AndyEngland521/Glasses_Revision/3D Parts/Button.SLDPRT

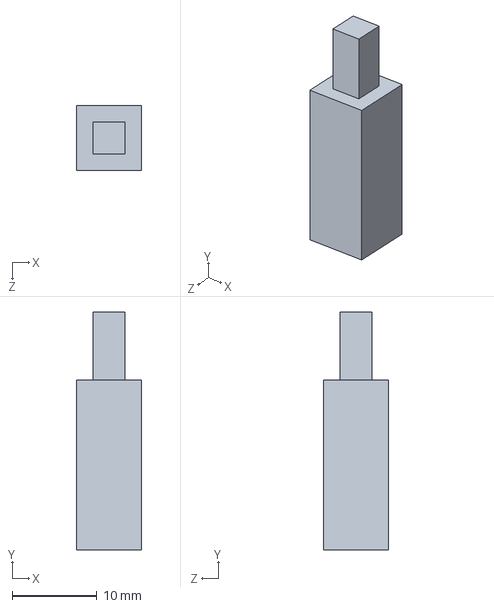
[picture p1: CAD file, 2018-12-07]
3D Parts/Button.SLDPRT
7.62 x 28.0 x 7.62 mm
