AndyEngland521/Glasses_Revision/3D Parts/Knob.SLDPRT

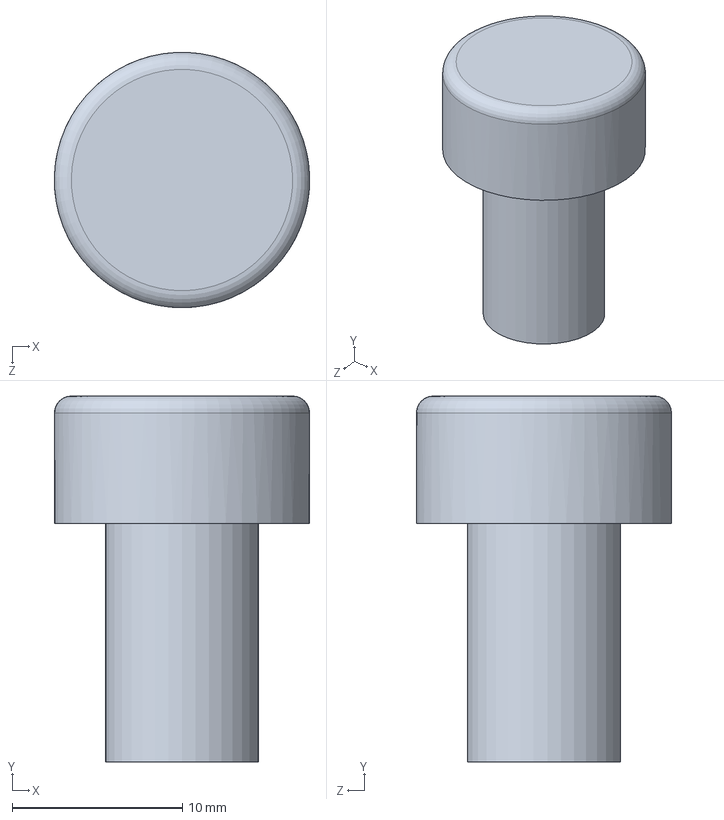
[picture p2: CAD file, 2018-12-07]
3D Parts/Knob.SLDPRT
15.0 x 21.5 x 15.0 mm
