AndyEngland521/Glasses_Revision/3D Parts/BrainBucket.SLDPRT

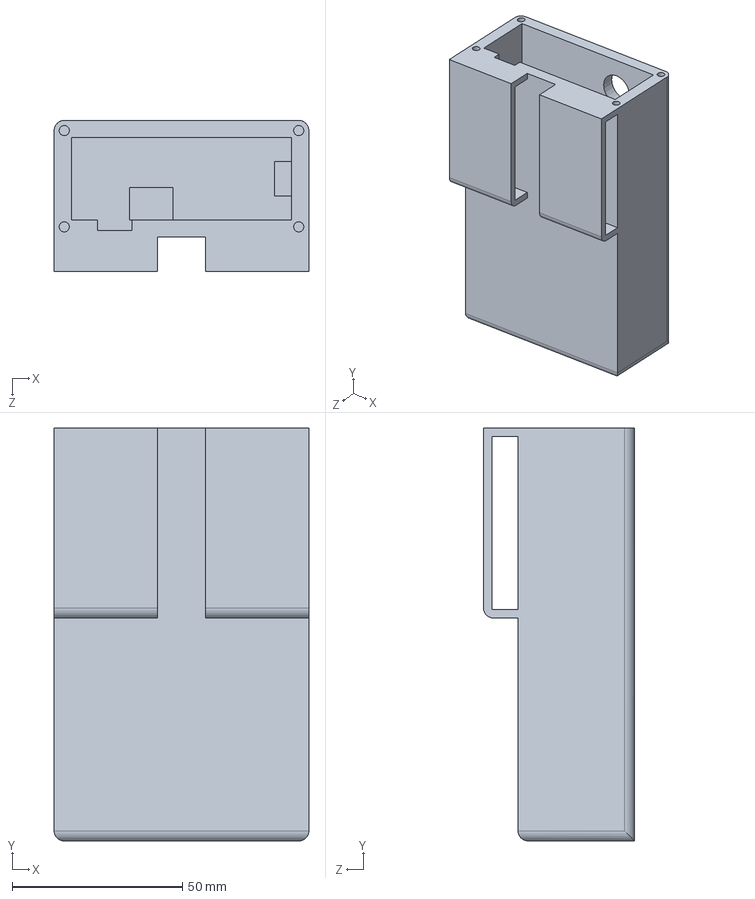
[picture p3: CAD file, 2018-12-05]
3D Parts/BrainBucket.SLDPRT
74.9 x 121.4 x 44.5 mm
