AndyEngland521/Glasses_Revision/3D Parts/BrainBucketnoLoop.SLDPRT

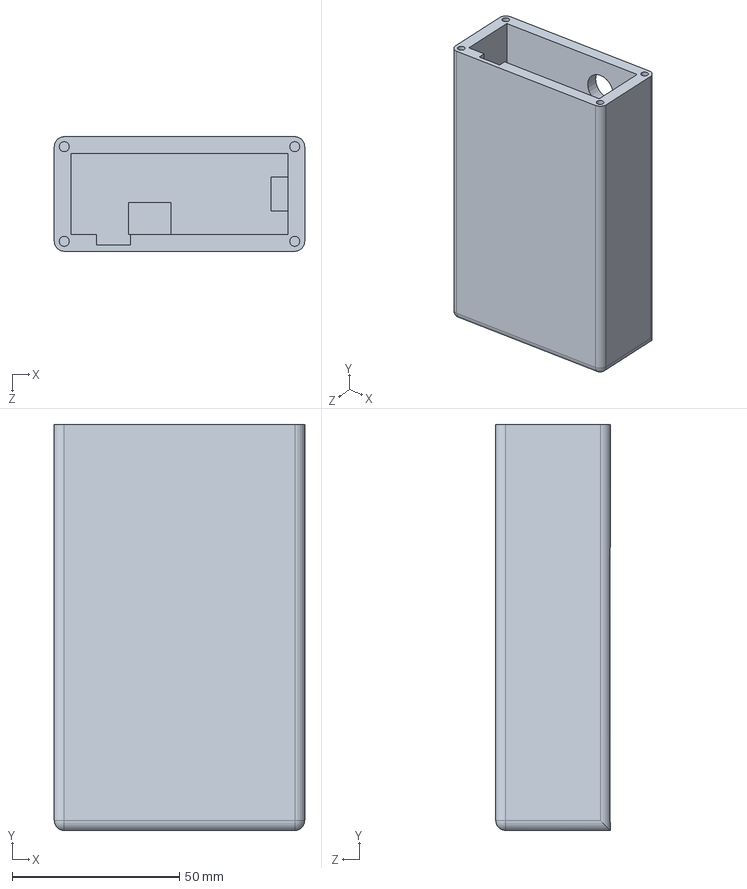
[picture p4: CAD file, 2018-12-05]
3D Parts/BrainBucketnoLoop.SLDPRT
74.9 x 121.4 x 34.3 mm
