AndyEngland521/Glasses_Revision/3D Parts/Stem.SLDPRT

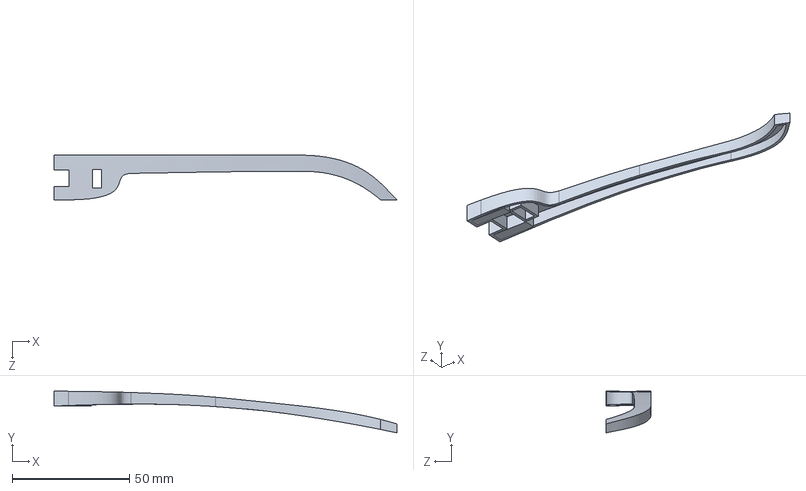
[picture p5: CAD file, 2018-12-05]
3D Parts/Stem.SLDPRT
146.1 x 17.8 x 19.1 mm
