AndyEngland521/Glasses_Revision/3D Parts/knobBottom.SLDPRT

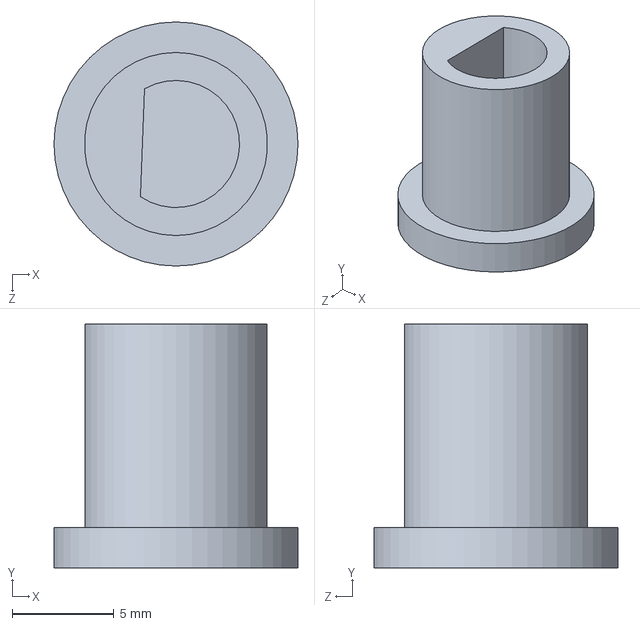
[picture p6: CAD file, 2018-06-23]
3D Parts/knobBottom.SLDPRT
12.0 x 12.0 x 12.0 mm
