AndyEngland521/Glasses_Revision/3D Parts/KnobTop.SLDPRT

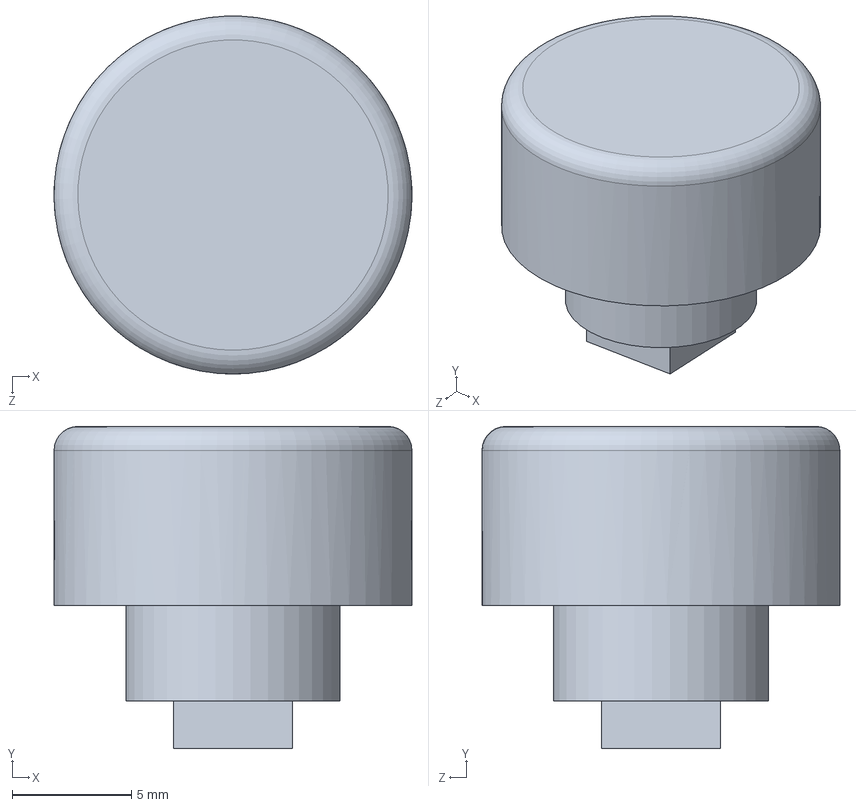
[picture p7: CAD file, 2018-06-23]
3D Parts/KnobTop.SLDPRT
15.0 x 13.5 x 15.0 mm
