AndyEngland521/Glasses_Revision/3D Parts/BrainCap.SLDPRT

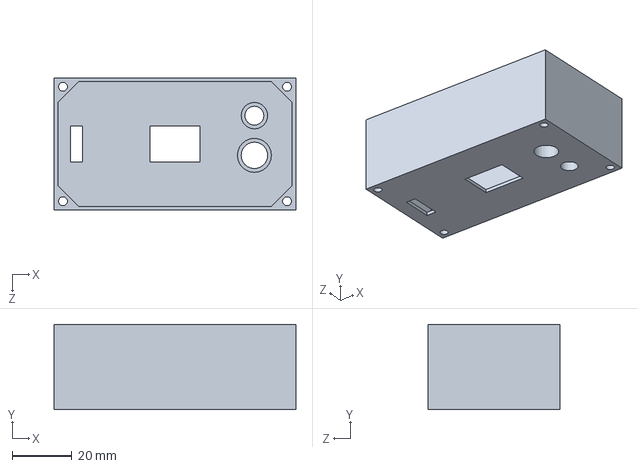
[picture p8: CAD file, 2018-05-03]
3D Parts/BrainCap.SLDPRT
81.3 x 28.6 x 44.5 mm
