AndyEngland521/Glasses_Revision/3D Parts/Stem_E.SLDPRT

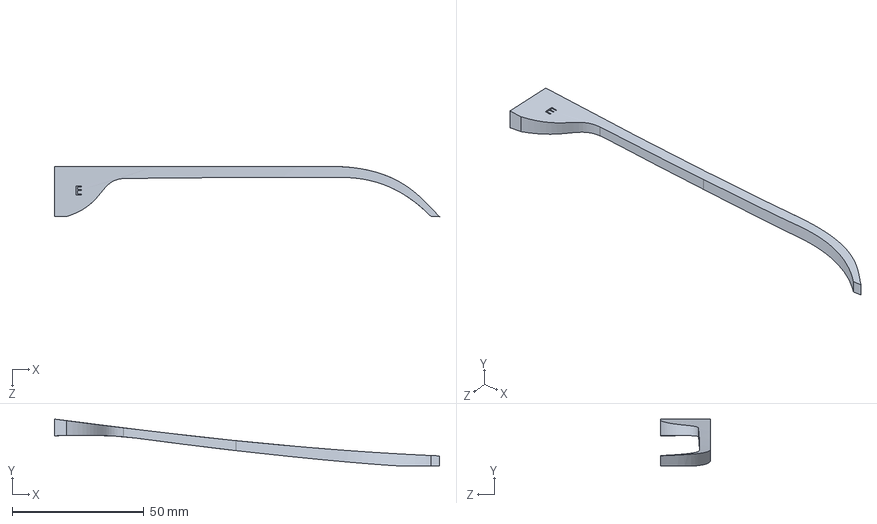
[picture p9: CAD file, 2018-03-30]
3D Parts/Stem_E.SLDPRT
146.1 x 17.8 x 19.1 mm
