AndyEngland521/Glasses_Revision/3D Parts/Stem_D.SLDPRT

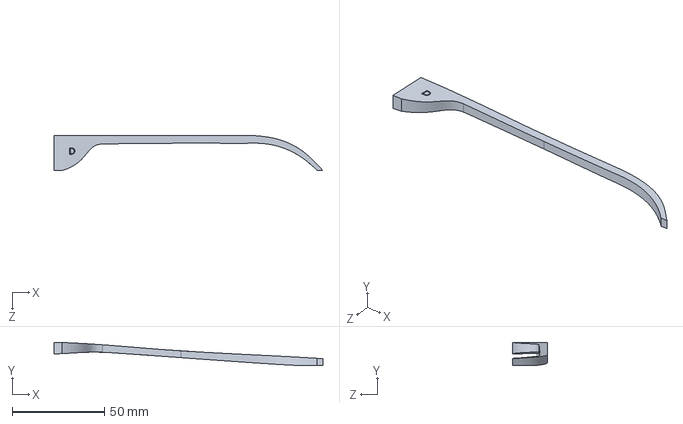
[picture p10: CAD file, 2018-03-30]
3D Parts/Stem_D.SLDPRT
146.1 x 12.7 x 19.1 mm
