AndyEngland521/Glasses_Revision/3D Parts/Stem_B.SLDPRT

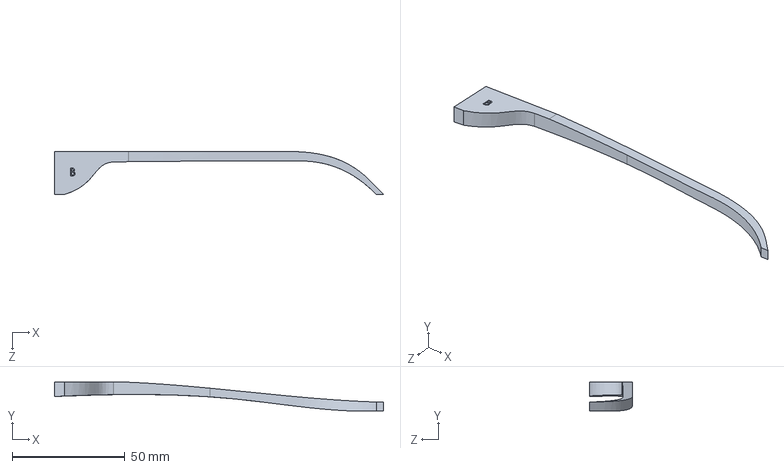
[picture p11: CAD file, 2018-03-26]
3D Parts/Stem_B.SLDPRT
146.1 x 12.7 x 19.1 mm
