AndyEngland521/Glasses_Revision/3D Parts/Stem_A.SLDPRT

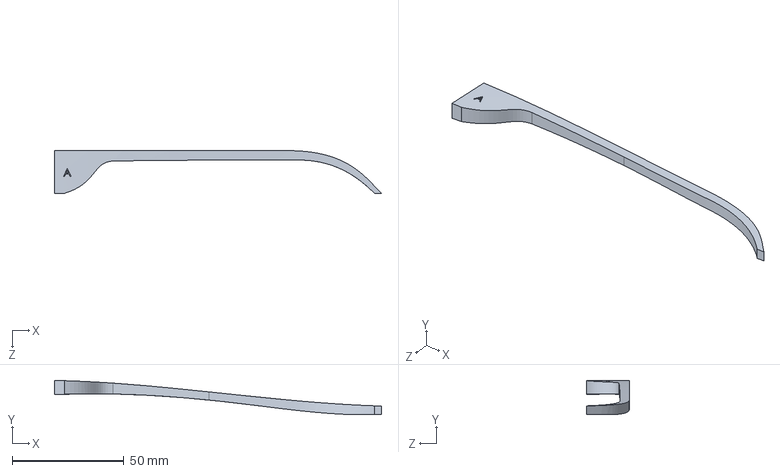
[picture p12: CAD file, 2018-03-26]
3D Parts/Stem_A.SLDPRT
146.1 x 15.2 x 19.1 mm
