AndyEngland521/Glasses_Revision/(list of files, cad)

Other CAD files:
3D Parts/Stem_C.SLDPRT
3D Parts/BrainBucket.STL
3D Parts/BrainBucketnoLoop.STL
3D Parts/BrainCap.STL
3D Parts/Button.STL
3D Parts/Knob.STL
3D Parts/KnobTop.STL
3D Parts/Stem.STL
3D Parts/Stem_A.STL
3D Parts/Stem_B.STL
3D Parts/Stem_C.STL
3D Parts/Stem_D.STL
3D Parts/Stem_E.STL
3D Parts/knobBottom.STL
