AndyEngland521/Glasses_Revision/Tutorial/AdvancedOutput.PNG

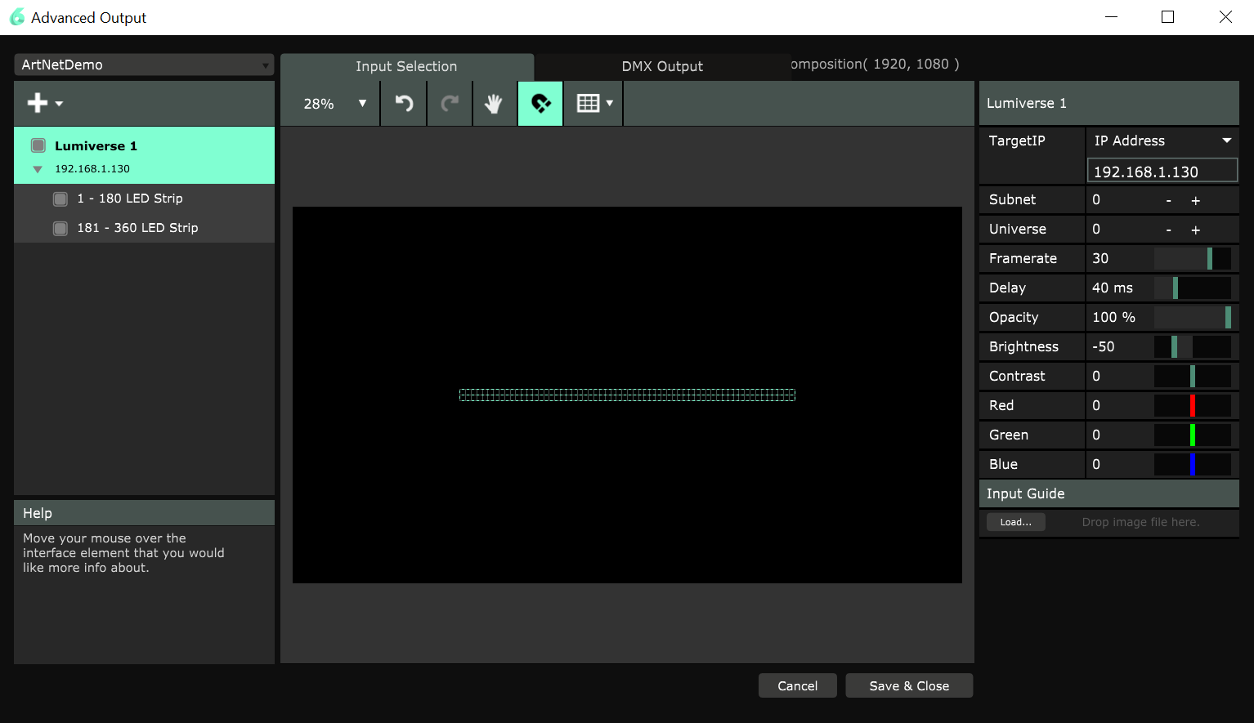
Tutorial/AdvancedOutput.PNG
