AndyEngland521/Glasses_Revision/Tutorial/CompositionSettings.PNG

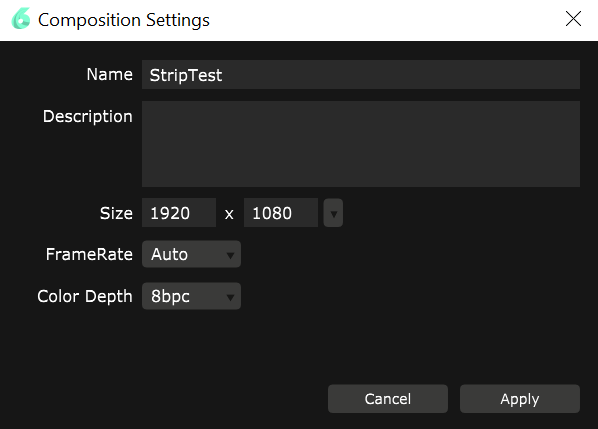
Tutorial/CompositionSettings.PNG
