AndyEngland521/Glasses_Revision/Tutorial/FixtureEditor.PNG

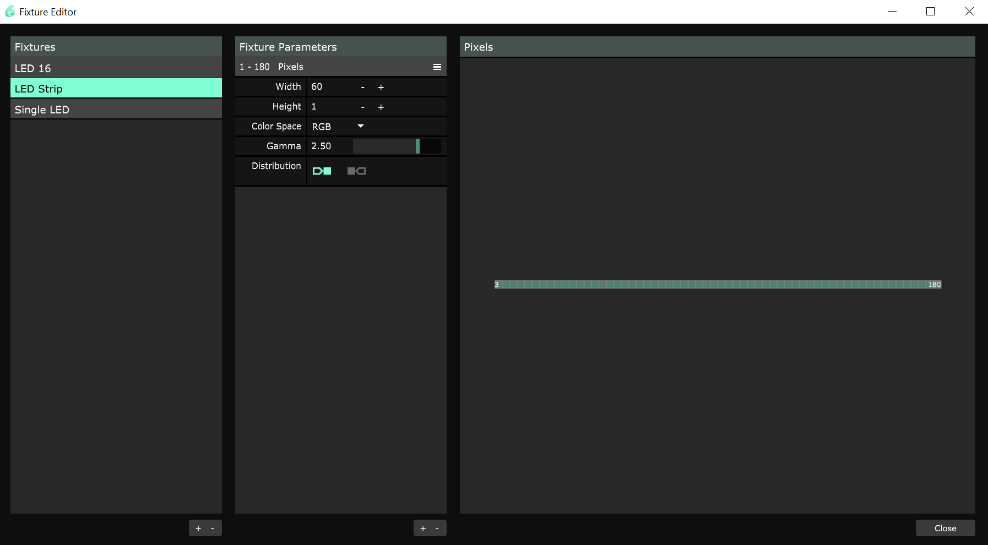
Tutorial/FixtureEditor.PNG
