AndyEngland521/Glasses_Revision/Boards/Glasses/mockup.pdf

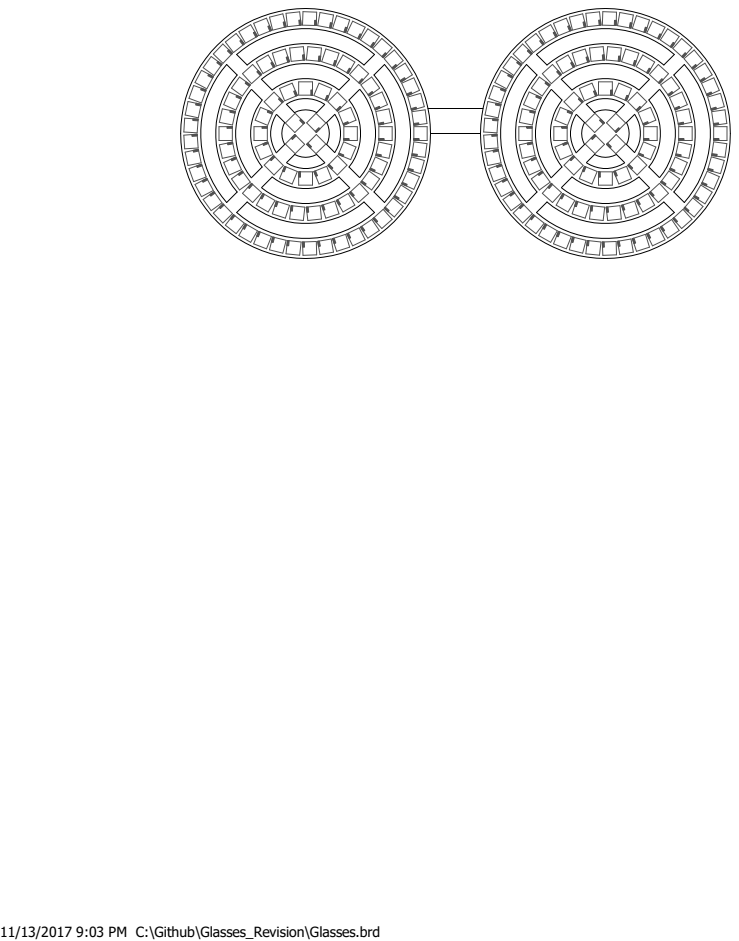
[picture p16: page 1]

11/13/2017 9:03 PM C:\Github\Glasses_Revision\Glasses.brd
