AndyEngland521/Glasses_Revision/Boards/Glasses/Glasses.brd

## EAGLE design Boards/Glasses/Glasses.brd (2018-12-06)

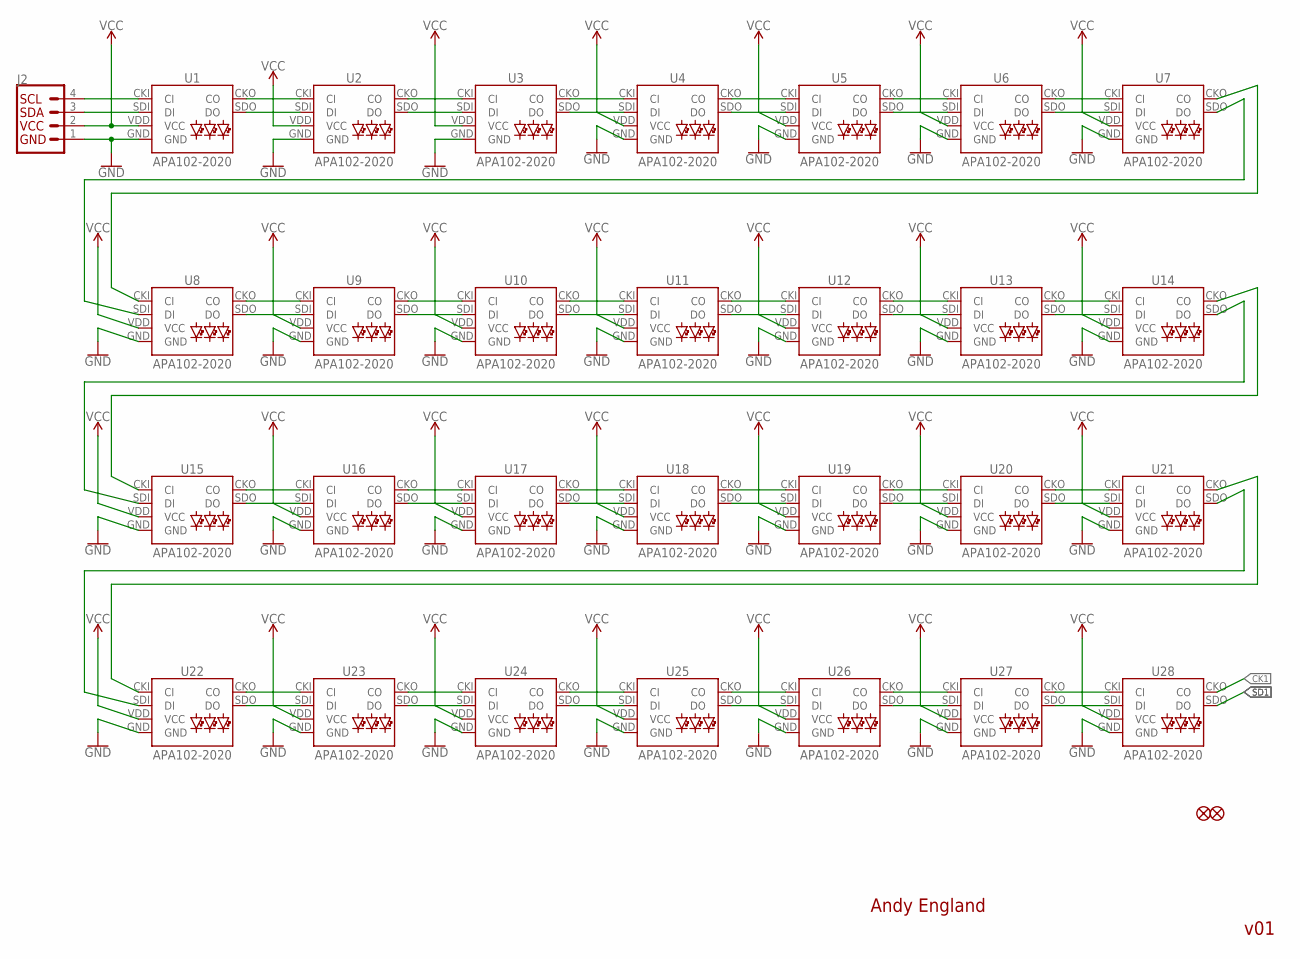
[picture p17: schematic Glasses.sch, sheet 1]

Parts:
FD1, FD2: FIDUCIALUFIDUCIAL; FIDUCIAL-MICRO
J2: QWIIC_CONNECTORJS-1MM; 1X04_1MM_RA
U1, U2, U3, U4, U5, U6, U7, U8, U9, U10, U11, U12, U13, U14, U15, U16, U17, U18, U19, U20, U21, U22, U23, U24, U25, U26, U27, U28: APA102-2020

Connections:
CK1: U28.CKO (CO); also elsewhere on the board
GND: J2.1, U1.GND, U2.GND, U3.GND, U4.GND, U5.GND, U6.GND, U7.GND, U8.GND, U9.GND, U10.GND, U11.GND, U12.GND, U13.GND, U14.GND, U15.GND, U16.GND, U17.GND, U18.GND, U19.GND, U20.GND, U21.GND, U22.GND, U23.GND, U24.GND, U25.GND, U26.GND, U27.GND, U28.GND; also elsewhere on the board
unnamed: U1.SDO (DO), U2.SDI (DI)
unnamed: U1.CKO (CO), U2.CKI (CI)
unnamed: U2.CKO (CO), U3.CKI (CI)
unnamed: U2.SDO (DO), U3.SDI (DI)
unnamed: U3.SDO (DO), U4.SDI (DI)
unnamed: U3.CKO (CO), U4.CKI (CI)
unnamed: U4.CKO (CO), U5.CKI (CI)
unnamed: U4.SDO (DO), U5.SDI (DI)
unnamed: U5.CKO (CO), U6.CKI (CI)
unnamed: U5.SDO (DO), U6.SDI (DI)
unnamed: U6.CKO (CO), U7.CKI (CI)
unnamed: U6.SDO (DO), U7.SDI (DI)
unnamed: U8.SDO (DO), U9.SDI (DI)
unnamed: U8.CKO (CO), U9.CKI (CI)
unnamed: U9.CKO (CO), U10.CKI (CI)
unnamed: U9.SDO (DO), U10.SDI (DI)
unnamed: U10.SDO (DO), U11.SDI (DI)
unnamed: U10.CKO (CO), U11.CKI (CI)
unnamed: U11.CKO (CO), U12.CKI (CI)
unnamed: U11.SDO (DO), U12.SDI (DI)
unnamed: U12.CKO (CO), U13.CKI (CI)
unnamed: U12.SDO (DO), U13.SDI (DI)
unnamed: U13.CKO (CO), U14.CKI (CI)
unnamed: U13.SDO (DO), U14.SDI (DI)
unnamed: U7.SDO (DO), U8.SDI (DI)
unnamed: U7.CKO (CO), U8.CKI (CI)
unnamed: U15.SDO (DO), U16.SDI (DI)
unnamed: U15.CKO (CO), U16.CKI (CI)
unnamed: U16.CKO (CO), U17.CKI (CI)
unnamed: U16.SDO (DO), U17.SDI (DI)
unnamed: U17.SDO (DO), U18.SDI (DI)
unnamed: U17.CKO (CO), U18.CKI (CI)
unnamed: U18.CKO (CO), U19.CKI (CI)
unnamed: U18.SDO (DO), U19.SDI (DI)
unnamed: U19.CKO (CO), U20.CKI (CI)
unnamed: U19.SDO (DO), U20.SDI (DI)
unnamed: U20.CKO (CO), U21.CKI (CI)
unnamed: U20.SDO (DO), U21.SDI (DI)
unnamed: U22.SDO (DO), U23.SDI (DI)
unnamed: U22.CKO (CO), U23.CKI (CI)
unnamed: U23.CKO (CO), U24.CKI (CI)
unnamed: U23.SDO (DO), U24.SDI (DI)
unnamed: U24.SDO (DO), U25.SDI (DI)
unnamed: U24.CKO (CO), U25.CKI (CI)
unnamed: U25.CKO (CO), U26.CKI (CI)
unnamed: U25.SDO (DO), U26.SDI (DI)
unnamed: U26.CKO (CO), U27.CKI (CI)
unnamed: U26.SDO (DO), U27.SDI (DI)
unnamed: U27.CKO (CO), U28.CKI (CI)
unnamed: U27.SDO (DO), U28.SDI (DI)
unnamed: U21.SDO (DO), U22.SDI (DI)
unnamed: U21.CKO (CO), U22.CKI (CI)
unnamed: U14.SDO (DO), U15.SDI (DI)
unnamed: U14.CKO (CO), U15.CKI (CI)
unnamed: J2.3, U1.SDI (DI)
unnamed: J2.4, U1.CKI (CI)
SD1: U28.SDO (DO); also elsewhere on the board
VCC: J2.2, U1.VDD (VCC), U2.VDD (VCC), U3.VDD (VCC), U4.VDD (VCC), U5.VDD (VCC), U6.VDD (VCC), U7.VDD (VCC), U8.VDD (VCC), U9.VDD (VCC), U10.VDD (VCC), U11.VDD (VCC), U12.VDD (VCC), U13.VDD (VCC), U14.VDD (VCC), U15.VDD (VCC), U16.VDD (VCC), U17.VDD (VCC), U18.VDD (VCC), U19.VDD (VCC), U20.VDD (VCC), U21.VDD (VCC), U22.VDD (VCC), U23.VDD (VCC), U24.VDD (VCC), U25.VDD (VCC), U26.VDD (VCC), U27.VDD (VCC), U28.VDD (VCC); also elsewhere on the board

Notes on the sheet:
Andy England
v01

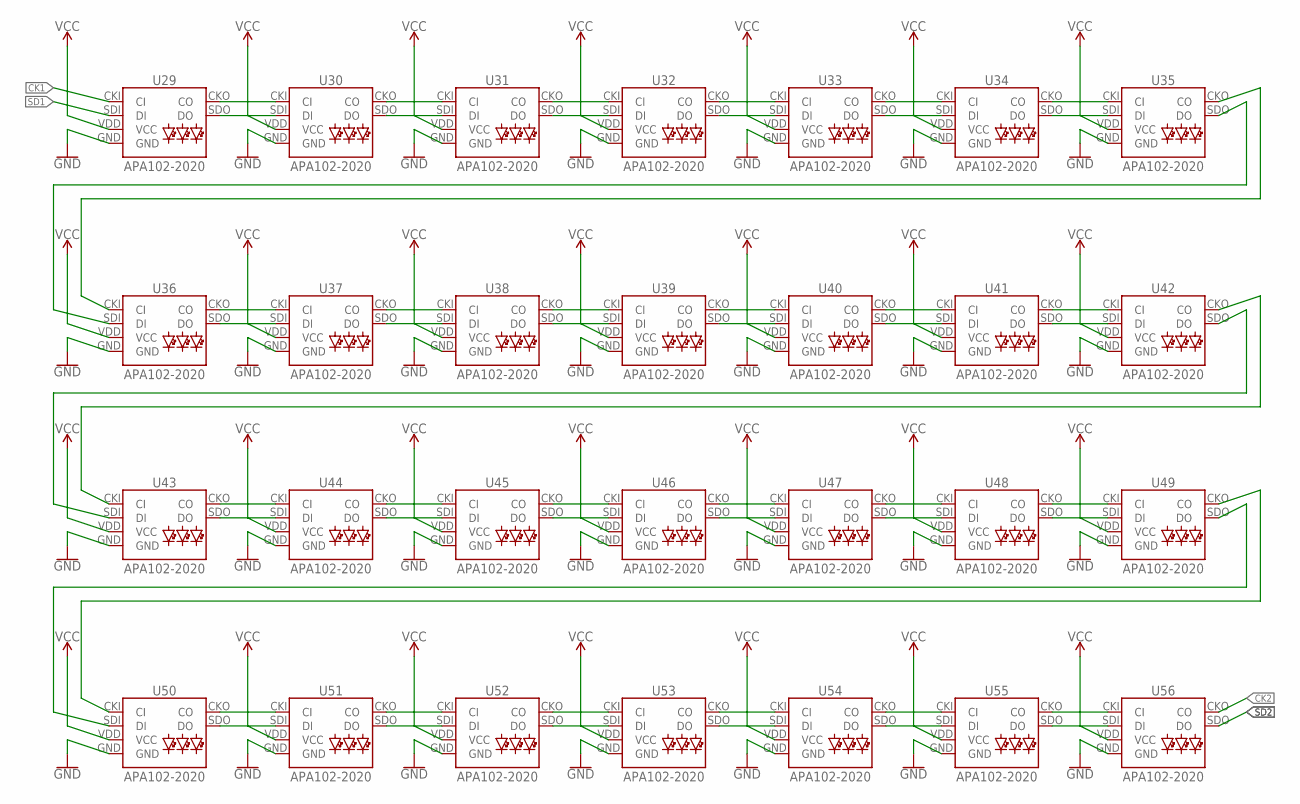
[picture p18: schematic Glasses.sch, sheet 2]

Parts:
U29, U30, U31, U32, U33, U34, U35, U36, U37, U38, U39, U40, U41, U42, U43, U44, U45, U46, U47, U48, U49, U50, U51, U52, U53, U54, U55, U56: APA102-2020

Connections:
CK1: U29.CKI (CI); also elsewhere on the board
CK2: U56.CKO (CO); also elsewhere on the board
GND: U29.GND, U30.GND, U31.GND, U32.GND, U33.GND, U34.GND, U35.GND, U36.GND, U37.GND, U38.GND, U39.GND, U40.GND, U41.GND, U42.GND, U43.GND, U44.GND, U45.GND, U46.GND, U47.GND, U48.GND, U49.GND, U50.GND, U51.GND, U52.GND, U53.GND, U54.GND, U55.GND, U56.GND; also elsewhere on the board
unnamed: U29.SDO (DO), U30.SDI (DI)
unnamed: U29.CKO (CO), U30.CKI (CI)
unnamed: U30.CKO (CO), U31.CKI (CI)
unnamed: U30.SDO (DO), U31.SDI (DI)
unnamed: U31.SDO (DO), U32.SDI (DI)
unnamed: U31.CKO (CO), U32.CKI (CI)
unnamed: U32.CKO (CO), U33.CKI (CI)
unnamed: U32.SDO (DO), U33.SDI (DI)
unnamed: U33.CKO (CO), U34.CKI (CI)
unnamed: U33.SDO (DO), U34.SDI (DI)
unnamed: U34.CKO (CO), U35.CKI (CI)
unnamed: U34.SDO (DO), U35.SDI (DI)
unnamed: U36.SDO (DO), U37.SDI (DI)
unnamed: U36.CKO (CO), U37.CKI (CI)
unnamed: U37.CKO (CO), U38.CKI (CI)
unnamed: U37.SDO (DO), U38.SDI (DI)
unnamed: U38.SDO (DO), U39.SDI (DI)
unnamed: U38.CKO (CO), U39.CKI (CI)
unnamed: U39.CKO (CO), U40.CKI (CI)
unnamed: U39.SDO (DO), U40.SDI (DI)
unnamed: U40.CKO (CO), U41.CKI (CI)
unnamed: U40.SDO (DO), U41.SDI (DI)
unnamed: U41.CKO (CO), U42.CKI (CI)
unnamed: U41.SDO (DO), U42.SDI (DI)
unnamed: U35.SDO (DO), U36.SDI (DI)
unnamed: U35.CKO (CO), U36.CKI (CI)
unnamed: U43.SDO (DO), U44.SDI (DI)
unnamed: U43.CKO (CO), U44.CKI (CI)
unnamed: U44.CKO (CO), U45.CKI (CI)
unnamed: U44.SDO (DO), U45.SDI (DI)
unnamed: U45.SDO (DO), U46.SDI (DI)
unnamed: U45.CKO (CO), U46.CKI (CI)
unnamed: U46.CKO (CO), U47.CKI (CI)
unnamed: U46.SDO (DO), U47.SDI (DI)
unnamed: U47.CKO (CO), U48.CKI (CI)
unnamed: U47.SDO (DO), U48.SDI (DI)
unnamed: U48.CKO (CO), U49.CKI (CI)
unnamed: U48.SDO (DO), U49.SDI (DI)
unnamed: U50.SDO (DO), U51.SDI (DI)
unnamed: U50.CKO (CO), U51.CKI (CI)
unnamed: U51.CKO (CO), U52.CKI (CI)
unnamed: U51.SDO (DO), U52.SDI (DI)
unnamed: U52.SDO (DO), U53.SDI (DI)
unnamed: U52.CKO (CO), U53.CKI (CI)
unnamed: U53.CKO (CO), U54.CKI (CI)
unnamed: U53.SDO (DO), U54.SDI (DI)
unnamed: U54.CKO (CO), U55.CKI (CI)
unnamed: U54.SDO (DO), U55.SDI (DI)
unnamed: U55.CKO (CO), U56.CKI (CI)
unnamed: U55.SDO (DO), U56.SDI (DI)
unnamed: U49.SDO (DO), U50.SDI (DI)
unnamed: U49.CKO (CO), U50.CKI (CI)
unnamed: U42.SDO (DO), U43.SDI (DI)
unnamed: U42.CKO (CO), U43.CKI (CI)
SD1: U29.SDI (DI); also elsewhere on the board
SD2: U56.SDO (DO); also elsewhere on the board
VCC: U29.VDD (VCC), U30.VDD (VCC), U31.VDD (VCC), U32.VDD (VCC), U33.VDD (VCC), U34.VDD (VCC), U35.VDD (VCC), U36.VDD (VCC), U37.VDD (VCC), U38.VDD (VCC), U39.VDD (VCC), U40.VDD (VCC), U41.VDD (VCC), U42.VDD (VCC), U43.VDD (VCC), U44.VDD (VCC), U45.VDD (VCC), U46.VDD (VCC), U47.VDD (VCC), U48.VDD (VCC), U49.VDD (VCC), U50.VDD (VCC), U51.VDD (VCC), U52.VDD (VCC), U53.VDD (VCC), U54.VDD (VCC), U55.VDD (VCC), U56.VDD (VCC); also elsewhere on the board

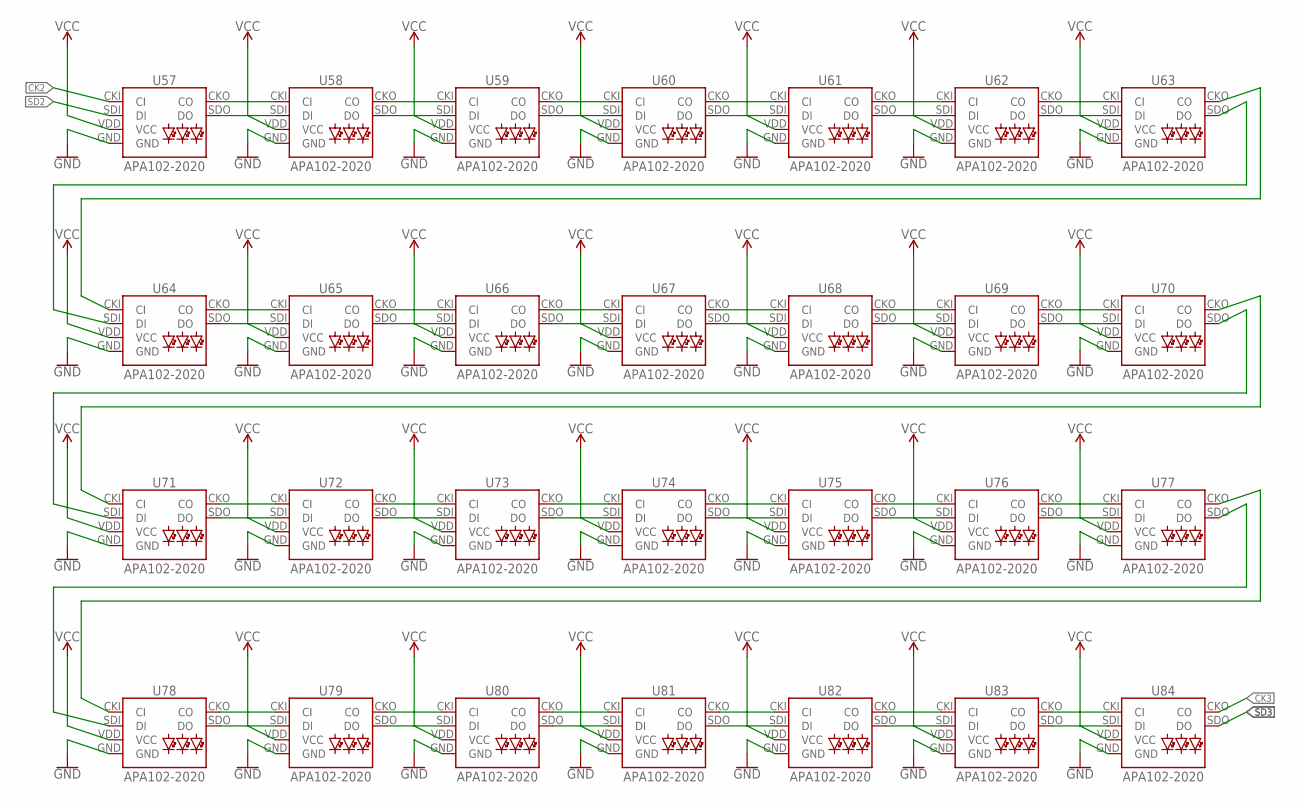
[picture p19: schematic Glasses.sch, sheet 3]

Parts:
U57, U58, U59, U60, U61, U62, U63, U64, U65, U66, U67, U68, U69, U70, U71, U72, U73, U74, U75, U76, U77, U78, U79, U80, U81, U82, U83, U84: APA102-2020

Connections:
CK2: U57.CKI (CI); also elsewhere on the board
CK3: U84.CKO (CO); also elsewhere on the board
GND: U57.GND, U58.GND, U59.GND, U60.GND, U61.GND, U62.GND, U63.GND, U64.GND, U65.GND, U66.GND, U67.GND, U68.GND, U69.GND, U70.GND, U71.GND, U72.GND, U73.GND, U74.GND, U75.GND, U76.GND, U77.GND, U78.GND, U79.GND, U80.GND, U81.GND, U82.GND, U83.GND, U84.GND; also elsewhere on the board
unnamed: U57.SDO (DO), U58.SDI (DI)
unnamed: U57.CKO (CO), U58.CKI (CI)
unnamed: U58.CKO (CO), U59.CKI (CI)
unnamed: U58.SDO (DO), U59.SDI (DI)
unnamed: U59.SDO (DO), U60.SDI (DI)
unnamed: U59.CKO (CO), U60.CKI (CI)
unnamed: U60.CKO (CO), U61.CKI (CI)
unnamed: U60.SDO (DO), U61.SDI (DI)
unnamed: U61.CKO (CO), U62.CKI (CI)
unnamed: U61.SDO (DO), U62.SDI (DI)
unnamed: U62.CKO (CO), U63.CKI (CI)
unnamed: U62.SDO (DO), U63.SDI (DI)
unnamed: U64.SDO (DO), U65.SDI (DI)
unnamed: U64.CKO (CO), U65.CKI (CI)
unnamed: U65.CKO (CO), U66.CKI (CI)
unnamed: U65.SDO (DO), U66.SDI (DI)
unnamed: U66.SDO (DO), U67.SDI (DI)
unnamed: U66.CKO (CO), U67.CKI (CI)
unnamed: U67.CKO (CO), U68.CKI (CI)
unnamed: U67.SDO (DO), U68.SDI (DI)
unnamed: U68.CKO (CO), U69.CKI (CI)
unnamed: U68.SDO (DO), U69.SDI (DI)
unnamed: U69.CKO (CO), U70.CKI (CI)
unnamed: U69.SDO (DO), U70.SDI (DI)
unnamed: U63.SDO (DO), U64.SDI (DI)
unnamed: U63.CKO (CO), U64.CKI (CI)
unnamed: U71.SDO (DO), U72.SDI (DI)
unnamed: U71.CKO (CO), U72.CKI (CI)
unnamed: U72.CKO (CO), U73.CKI (CI)
unnamed: U72.SDO (DO), U73.SDI (DI)
unnamed: U73.SDO (DO), U74.SDI (DI)
unnamed: U73.CKO (CO), U74.CKI (CI)
unnamed: U74.CKO (CO), U75.CKI (CI)
unnamed: U74.SDO (DO), U75.SDI (DI)
unnamed: U75.CKO (CO), U76.CKI (CI)
unnamed: U75.SDO (DO), U76.SDI (DI)
unnamed: U76.CKO (CO), U77.CKI (CI)
unnamed: U76.SDO (DO), U77.SDI (DI)
unnamed: U78.SDO (DO), U79.SDI (DI)
unnamed: U78.CKO (CO), U79.CKI (CI)
unnamed: U79.CKO (CO), U80.CKI (CI)
unnamed: U79.SDO (DO), U80.SDI (DI)
unnamed: U80.SDO (DO), U81.SDI (DI)
unnamed: U80.CKO (CO), U81.CKI (CI)
unnamed: U81.CKO (CO), U82.CKI (CI)
unnamed: U81.SDO (DO), U82.SDI (DI)
unnamed: U82.CKO (CO), U83.CKI (CI)
unnamed: U82.SDO (DO), U83.SDI (DI)
unnamed: U83.CKO (CO), U84.CKI (CI)
unnamed: U83.SDO (DO), U84.SDI (DI)
unnamed: U77.SDO (DO), U78.SDI (DI)
unnamed: U77.CKO (CO), U78.CKI (CI)
unnamed: U70.SDO (DO), U71.SDI (DI)
unnamed: U70.CKO (CO), U71.CKI (CI)
SD2: U57.SDI (DI); also elsewhere on the board
SD3: U84.SDO (DO); also elsewhere on the board
VCC: U57.VDD (VCC), U58.VDD (VCC), U59.VDD (VCC), U60.VDD (VCC), U61.VDD (VCC), U62.VDD (VCC), U63.VDD (VCC), U64.VDD (VCC), U65.VDD (VCC), U66.VDD (VCC), U67.VDD (VCC), U68.VDD (VCC), U69.VDD (VCC), U70.VDD (VCC), U71.VDD (VCC), U72.VDD (VCC), U73.VDD (VCC), U74.VDD (VCC), U75.VDD (VCC), U76.VDD (VCC), U77.VDD (VCC), U78.VDD (VCC), U79.VDD (VCC), U80.VDD (VCC), U81.VDD (VCC), U82.VDD (VCC), U83.VDD (VCC), U84.VDD (VCC); also elsewhere on the board

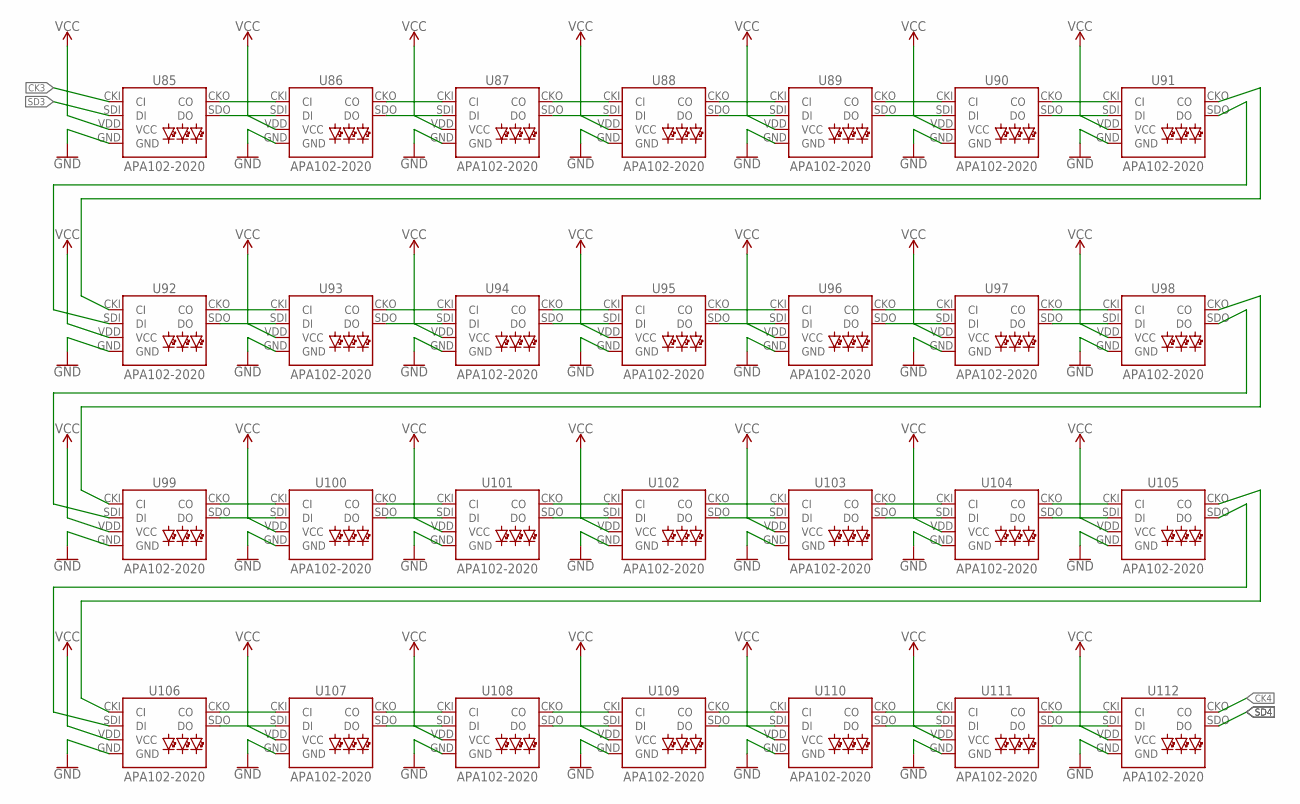
[picture p20: schematic Glasses.sch, sheet 4]

Parts:
U85, U86, U87, U88, U89, U90, U91, U92, U93, U94, U95, U96, U97, U98, U99, U100, U101, U102, U103, U104, U105, U106, U107, U108, U109, U110, U111, U112: APA102-2020

Connections:
CK3: U85.CKI (CI); also elsewhere on the board
CK4: U112.CKO (CO); also elsewhere on the board
GND: U85.GND, U86.GND, U87.GND, U88.GND, U89.GND, U90.GND, U91.GND, U92.GND, U93.GND, U94.GND, U95.GND, U96.GND, U97.GND, U98.GND, U99.GND, U100.GND, U101.GND, U102.GND, U103.GND, U104.GND, U105.GND, U106.GND, U107.GND, U108.GND, U109.GND, U110.GND, U111.GND, U112.GND; also elsewhere on the board
unnamed: U85.SDO (DO), U86.SDI (DI)
unnamed: U85.CKO (CO), U86.CKI (CI)
unnamed: U86.CKO (CO), U87.CKI (CI)
unnamed: U86.SDO (DO), U87.SDI (DI)
unnamed: U87.SDO (DO), U88.SDI (DI)
unnamed: U87.CKO (CO), U88.CKI (CI)
unnamed: U88.CKO (CO), U89.CKI (CI)
unnamed: U88.SDO (DO), U89.SDI (DI)
unnamed: U89.CKO (CO), U90.CKI (CI)
unnamed: U89.SDO (DO), U90.SDI (DI)
unnamed: U90.CKO (CO), U91.CKI (CI)
unnamed: U90.SDO (DO), U91.SDI (DI)
unnamed: U92.SDO (DO), U93.SDI (DI)
unnamed: U92.CKO (CO), U93.CKI (CI)
unnamed: U93.CKO (CO), U94.CKI (CI)
unnamed: U93.SDO (DO), U94.SDI (DI)
unnamed: U94.SDO (DO), U95.SDI (DI)
unnamed: U94.CKO (CO), U95.CKI (CI)
unnamed: U95.SDO (DO), U96.SDI (DI)
unnamed: U95.CKO (CO), U96.CKI (CI)
unnamed: U96.CKO (CO), U97.CKI (CI)
unnamed: U96.SDO (DO), U97.SDI (DI)
unnamed: U97.CKO (CO), U98.CKI (CI)
unnamed: U97.SDO (DO), U98.SDI (DI)
unnamed: U91.SDO (DO), U92.SDI (DI)
unnamed: U91.CKO (CO), U92.CKI (CI)
unnamed: U99.SDO (DO), U100.SDI (DI)
unnamed: U99.CKO (CO), U100.CKI (CI)
unnamed: U100.CKO (CO), U101.CKI (CI)
unnamed: U100.SDO (DO), U101.SDI (DI)
unnamed: U101.SDO (DO), U102.SDI (DI)
unnamed: U101.CKO (CO), U102.CKI (CI)
unnamed: U102.CKO (CO), U103.CKI (CI)
unnamed: U102.SDO (DO), U103.SDI (DI)
unnamed: U103.CKO (CO), U104.CKI (CI)
unnamed: U103.SDO (DO), U104.SDI (DI)
unnamed: U104.CKO (CO), U105.CKI (CI)
unnamed: U104.SDO (DO), U105.SDI (DI)
unnamed: U106.SDO (DO), U107.SDI (DI)
unnamed: U106.CKO (CO), U107.CKI (CI)
unnamed: U107.CKO (CO), U108.CKI (CI)
unnamed: U107.SDO (DO), U108.SDI (DI)
unnamed: U108.SDO (DO), U109.SDI (DI)
unnamed: U108.CKO (CO), U109.CKI (CI)
unnamed: U109.CKO (CO), U110.CKI (CI)
unnamed: U109.SDO (DO), U110.SDI (DI)
unnamed: U110.CKO (CO), U111.CKI (CI)
unnamed: U110.SDO (DO), U111.SDI (DI)
unnamed: U111.CKO (CO), U112.CKI (CI)
unnamed: U111.SDO (DO), U112.SDI (DI)
unnamed: U105.SDO (DO), U106.SDI (DI)
unnamed: U105.CKO (CO), U106.CKI (CI)
unnamed: U98.SDO (DO), U99.SDI (DI)
unnamed: U98.CKO (CO), U99.CKI (CI)
SD3: U85.SDI (DI); also elsewhere on the board
SD4: U112.SDO (DO); also elsewhere on the board
VCC: U85.VDD (VCC), U86.VDD (VCC), U87.VDD (VCC), U88.VDD (VCC), U89.VDD (VCC), U90.VDD (VCC), U91.VDD (VCC), U92.VDD (VCC), U93.VDD (VCC), U94.VDD (VCC), U95.VDD (VCC), U96.VDD (VCC), U97.VDD (VCC), U98.VDD (VCC), U99.VDD (VCC), U100.VDD (VCC), U101.VDD (VCC), U102.VDD (VCC), U103.VDD (VCC), U104.VDD (VCC), U105.VDD (VCC), U106.VDD (VCC), U107.VDD (VCC), U108.VDD (VCC), U109.VDD (VCC), U110.VDD (VCC), U111.VDD (VCC), U112.VDD (VCC); also elsewhere on the board

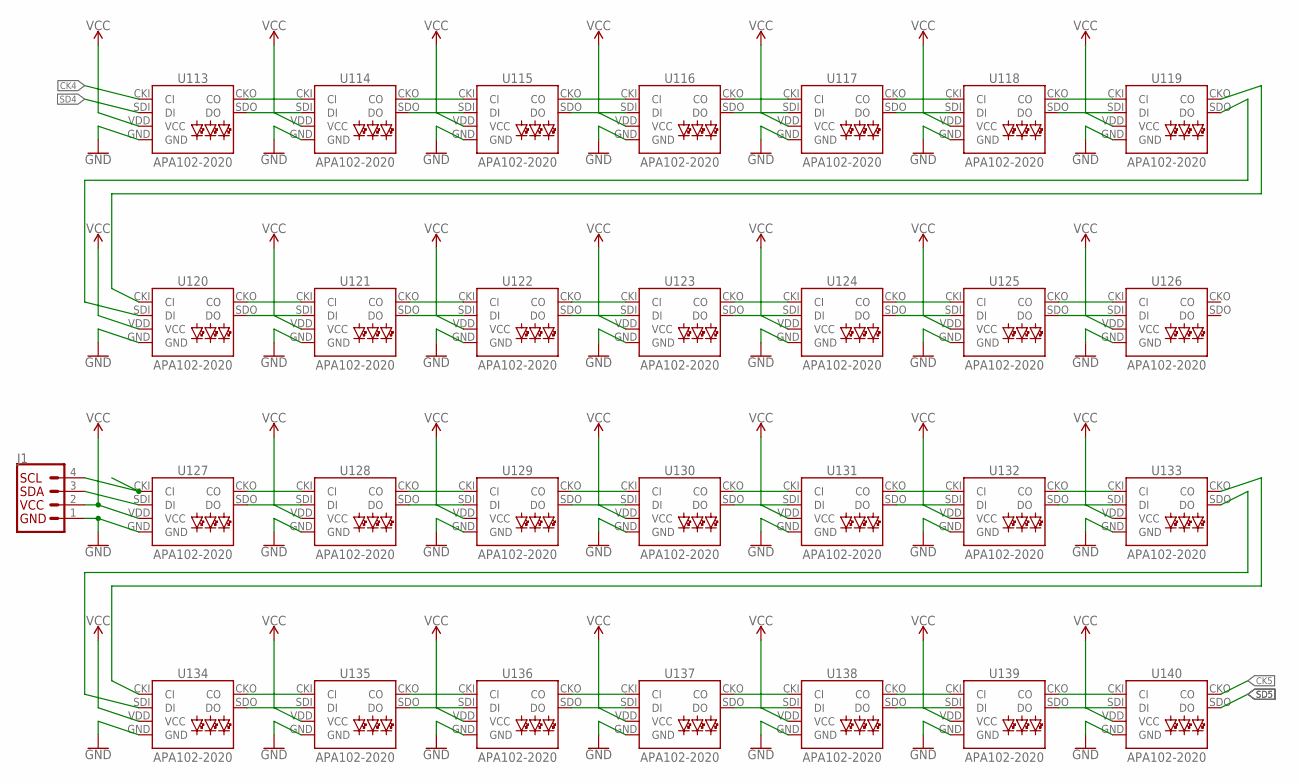
[picture p21: schematic Glasses.sch, sheet 5]

Parts:
J1: QWIIC_CONNECTORJS-1MM; 1X04_1MM_RA
U113, U114, U115, U116, U117, U118, U119, U120, U121, U122, U123, U124, U125, U126, U127, U128, U129, U130, U131, U132, U133, U134, U135, U136, U137, U138, U139, U140: APA102-2020

Connections:
CK4: U113.CKI (CI); also elsewhere on the board
CK5: U140.CKO (CO); also elsewhere on the board
GND: J1.1, U113.GND, U114.GND, U115.GND, U116.GND, U117.GND, U118.GND, U119.GND, U120.GND, U121.GND, U122.GND, U123.GND, U124.GND, U125.GND, U126.GND, U127.GND, U128.GND, U129.GND, U130.GND, U131.GND, U132.GND, U133.GND, U134.GND, U135.GND, U136.GND, U137.GND, U138.GND, U139.GND, U140.GND; also elsewhere on the board
unnamed: U113.SDO (DO), U114.SDI (DI)
unnamed: U113.CKO (CO), U114.CKI (CI)
unnamed: U114.CKO (CO), U115.CKI (CI)
unnamed: U114.SDO (DO), U115.SDI (DI)
unnamed: U115.SDO (DO), U116.SDI (DI)
unnamed: U115.CKO (CO), U116.CKI (CI)
unnamed: U116.CKO (CO), U117.CKI (CI)
unnamed: U116.SDO (DO), U117.SDI (DI)
unnamed: U117.CKO (CO), U118.CKI (CI)
unnamed: U117.SDO (DO), U118.SDI (DI)
unnamed: U118.CKO (CO), U119.CKI (CI)
unnamed: U118.SDO (DO), U119.SDI (DI)
unnamed: U120.SDO (DO), U121.SDI (DI)
unnamed: U120.CKO (CO), U121.CKI (CI)
unnamed: U121.CKO (CO), U122.CKI (CI)
unnamed: U121.SDO (DO), U122.SDI (DI)
unnamed: U122.SDO (DO), U123.SDI (DI)
unnamed: U122.CKO (CO), U123.CKI (CI)
unnamed: U123.CKO (CO), U124.CKI (CI)
unnamed: U123.SDO (DO), U124.SDI (DI)
unnamed: U124.CKO (CO), U125.CKI (CI)
unnamed: U124.SDO (DO), U125.SDI (DI)
unnamed: U125.CKO (CO), U126.CKI (CI)
unnamed: U125.SDO (DO), U126.SDI (DI)
unnamed: U119.SDO (DO), U120.SDI (DI)
unnamed: U119.CKO (CO), U120.CKI (CI)
unnamed: U127.SDO (DO), U128.SDI (DI)
unnamed: U127.CKO (CO), U128.CKI (CI)
unnamed: U128.CKO (CO), U129.CKI (CI)
unnamed: U128.SDO (DO), U129.SDI (DI)
unnamed: U129.SDO (DO), U130.SDI (DI)
unnamed: U129.CKO (CO), U130.CKI (CI)
unnamed: U130.CKO (CO), U131.CKI (CI)
unnamed: U130.SDO (DO), U131.SDI (DI)
unnamed: U131.CKO (CO), U132.CKI (CI)
unnamed: U131.SDO (DO), U132.SDI (DI)
unnamed: U132.CKO (CO), U133.CKI (CI)
unnamed: U132.SDO (DO), U133.SDI (DI)
unnamed: U134.SDO (DO), U135.SDI (DI)
unnamed: U134.CKO (CO), U135.CKI (CI)
unnamed: U135.CKO (CO), U136.CKI (CI)
unnamed: U135.SDO (DO), U136.SDI (DI)
unnamed: U136.SDO (DO), U137.SDI (DI)
unnamed: U136.CKO (CO), U137.CKI (CI)
unnamed: U137.CKO (CO), U138.CKI (CI)
unnamed: U137.SDO (DO), U138.SDI (DI)
unnamed: U138.CKO (CO), U139.CKI (CI)
unnamed: U138.SDO (DO), U139.SDI (DI)
unnamed: U139.CKO (CO), U140.CKI (CI)
unnamed: U139.SDO (DO), U140.SDI (DI)
unnamed: U133.SDO (DO), U134.SDI (DI)
unnamed: U133.CKO (CO), U134.CKI (CI)
unnamed: J1.3, U127.SDI (DI)
unnamed: J1.4, U127.CKI (CI)
SD4: U113.SDI (DI); also elsewhere on the board
SD5: U140.SDO (DO); also elsewhere on the board
VCC: J1.2, U113.VDD (VCC), U114.VDD (VCC), U115.VDD (VCC), U116.VDD (VCC), U117.VDD (VCC), U118.VDD (VCC), U119.VDD (VCC), U120.VDD (VCC), U121.VDD (VCC), U122.VDD (VCC), U123.VDD (VCC), U124.VDD (VCC), U125.VDD (VCC), U126.VDD (VCC), U127.VDD (VCC), U128.VDD (VCC), U129.VDD (VCC), U130.VDD (VCC), U131.VDD (VCC), U132.VDD (VCC), U133.VDD (VCC), U134.VDD (VCC), U135.VDD (VCC), U136.VDD (VCC), U137.VDD (VCC), U138.VDD (VCC), U139.VDD (VCC), U140.VDD (VCC); also elsewhere on the board

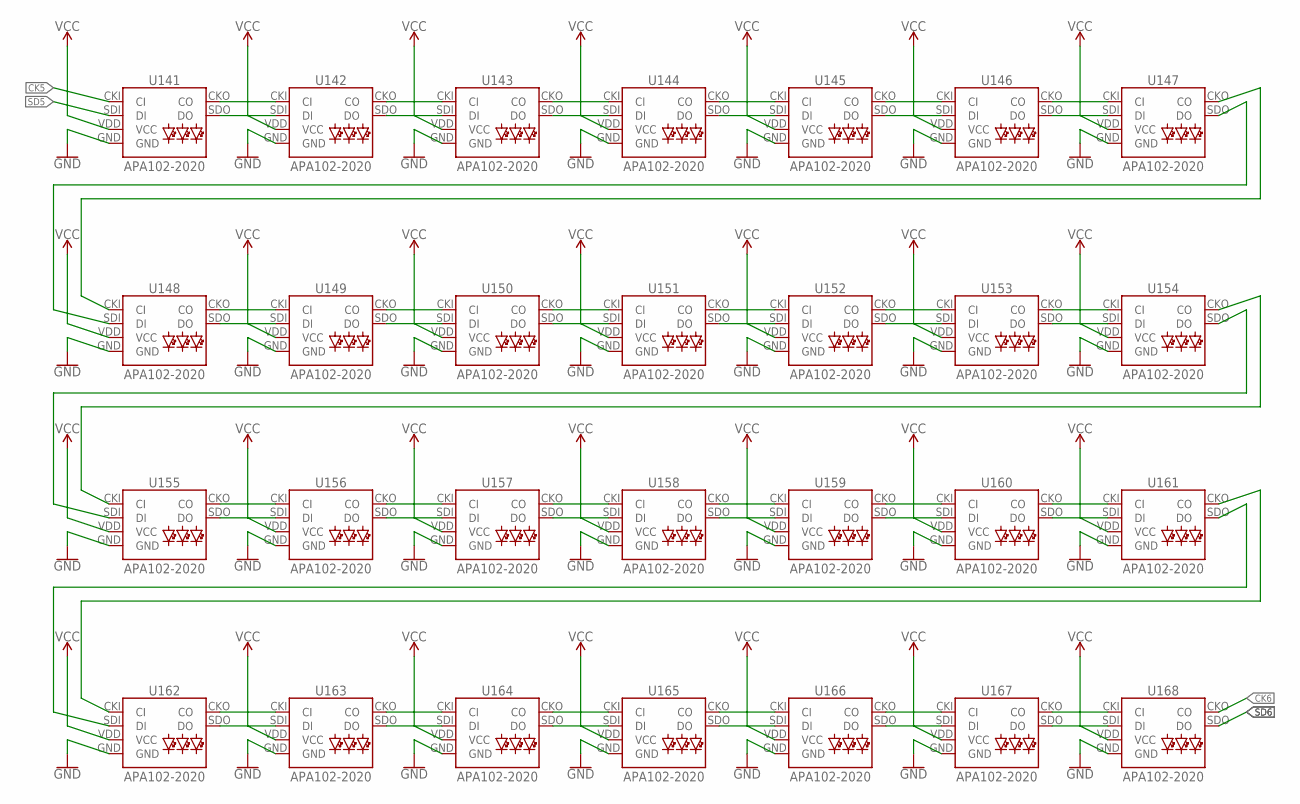
[picture p22: schematic Glasses.sch, sheet 6]

Parts:
U141, U142, U143, U144, U145, U146, U147, U148, U149, U150, U151, U152, U153, U154, U155, U156, U157, U158, U159, U160, U161, U162, U163, U164, U165, U166, U167, U168: APA102-2020

Connections:
CK5: U141.CKI (CI); also elsewhere on the board
CK6: U168.CKO (CO); also elsewhere on the board
GND: U141.GND, U142.GND, U143.GND, U144.GND, U145.GND, U146.GND, U147.GND, U148.GND, U149.GND, U150.GND, U151.GND, U152.GND, U153.GND, U154.GND, U155.GND, U156.GND, U157.GND, U158.GND, U159.GND, U160.GND, U161.GND, U162.GND, U163.GND, U164.GND, U165.GND, U166.GND, U167.GND, U168.GND; also elsewhere on the board
unnamed: U141.SDO (DO), U142.SDI (DI)
unnamed: U141.CKO (CO), U142.CKI (CI)
unnamed: U142.CKO (CO), U143.CKI (CI)
unnamed: U142.SDO (DO), U143.SDI (DI)
unnamed: U143.SDO (DO), U144.SDI (DI)
unnamed: U143.CKO (CO), U144.CKI (CI)
unnamed: U144.CKO (CO), U145.CKI (CI)
unnamed: U144.SDO (DO), U145.SDI (DI)
unnamed: U145.CKO (CO), U146.CKI (CI)
unnamed: U145.SDO (DO), U146.SDI (DI)
unnamed: U146.CKO (CO), U147.CKI (CI)
unnamed: U146.SDO (DO), U147.SDI (DI)
unnamed: U148.SDO (DO), U149.SDI (DI)
unnamed: U148.CKO (CO), U149.CKI (CI)
unnamed: U149.CKO (CO), U150.CKI (CI)
unnamed: U149.SDO (DO), U150.SDI (DI)
unnamed: U150.SDO (DO), U151.SDI (DI)
unnamed: U150.CKO (CO), U151.CKI (CI)
unnamed: U151.CKO (CO), U152.CKI (CI)
unnamed: U151.SDO (DO), U152.SDI (DI)
unnamed: U152.CKO (CO), U153.CKI (CI)
unnamed: U152.SDO (DO), U153.SDI (DI)
unnamed: U153.CKO (CO), U154.CKI (CI)
unnamed: U153.SDO (DO), U154.SDI (DI)
unnamed: U147.SDO (DO), U148.SDI (DI)
unnamed: U147.CKO (CO), U148.CKI (CI)
unnamed: U155.SDO (DO), U156.SDI (DI)
unnamed: U155.CKO (CO), U156.CKI (CI)
unnamed: U156.CKO (CO), U157.CKI (CI)
unnamed: U156.SDO (DO), U157.SDI (DI)
unnamed: U157.SDO (DO), U158.SDI (DI)
unnamed: U157.CKO (CO), U158.CKI (CI)
unnamed: U158.CKO (CO), U159.CKI (CI)
unnamed: U158.SDO (DO), U159.SDI (DI)
unnamed: U159.CKO (CO), U160.CKI (CI)
unnamed: U159.SDO (DO), U160.SDI (DI)
unnamed: U160.CKO (CO), U161.CKI (CI)
unnamed: U160.SDO (DO), U161.SDI (DI)
unnamed: U162.SDO (DO), U163.SDI (DI)
unnamed: U162.CKO (CO), U163.CKI (CI)
unnamed: U163.CKO (CO), U164.CKI (CI)
unnamed: U163.SDO (DO), U164.SDI (DI)
unnamed: U164.SDO (DO), U165.SDI (DI)
unnamed: U164.CKO (CO), U165.CKI (CI)
unnamed: U165.CKO (CO), U166.CKI (CI)
unnamed: U165.SDO (DO), U166.SDI (DI)
unnamed: U166.CKO (CO), U167.CKI (CI)
unnamed: U166.SDO (DO), U167.SDI (DI)
unnamed: U167.CKO (CO), U168.CKI (CI)
unnamed: U167.SDO (DO), U168.SDI (DI)
unnamed: U161.SDO (DO), U162.SDI (DI)
unnamed: U161.CKO (CO), U162.CKI (CI)
unnamed: U154.SDO (DO), U155.SDI (DI)
unnamed: U154.CKO (CO), U155.CKI (CI)
SD5: U141.SDI (DI); also elsewhere on the board
SD6: U168.SDO (DO); also elsewhere on the board
VCC: U141.VDD (VCC), U142.VDD (VCC), U143.VDD (VCC), U144.VDD (VCC), U145.VDD (VCC), U146.VDD (VCC), U147.VDD (VCC), U148.VDD (VCC), U149.VDD (VCC), U150.VDD (VCC), U151.VDD (VCC), U152.VDD (VCC), U153.VDD (VCC), U154.VDD (VCC), U155.VDD (VCC), U156.VDD (VCC), U157.VDD (VCC), U158.VDD (VCC), U159.VDD (VCC), U160.VDD (VCC), U161.VDD (VCC), U162.VDD (VCC), U163.VDD (VCC), U164.VDD (VCC), U165.VDD (VCC), U166.VDD (VCC), U167.VDD (VCC), U168.VDD (VCC); also elsewhere on the board

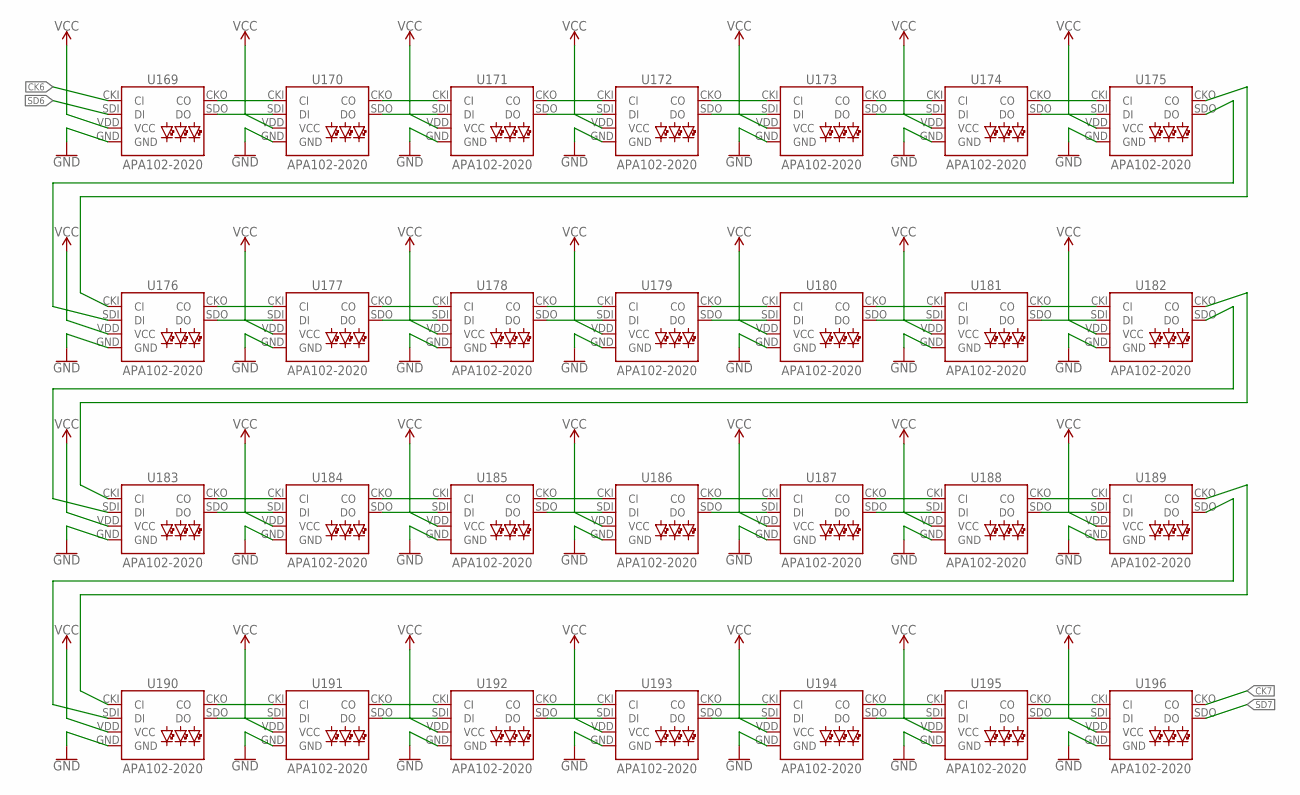
[picture p23: schematic Glasses.sch, sheet 7]

Parts:
U169, U170, U171, U172, U173, U174, U175, U176, U177, U178, U179, U180, U181, U182, U183, U184, U185, U186, U187, U188, U189, U190, U191, U192, U193, U194, U195, U196: APA102-2020

Connections:
CK6: U169.CKI (CI); also elsewhere on the board
CK7: U196.CKO (CO); also elsewhere on the board
GND: U169.GND, U170.GND, U171.GND, U172.GND, U173.GND, U174.GND, U175.GND, U176.GND, U177.GND, U178.GND, U179.GND, U180.GND, U181.GND, U182.GND, U183.GND, U184.GND, U185.GND, U186.GND, U187.GND, U188.GND, U189.GND, U190.GND, U191.GND, U192.GND, U193.GND, U194.GND, U195.GND, U196.GND; also elsewhere on the board
unnamed: U169.SDO (DO), U170.SDI (DI)
unnamed: U169.CKO (CO), U170.CKI (CI)
unnamed: U170.CKO (CO), U171.CKI (CI)
unnamed: U170.SDO (DO), U171.SDI (DI)
unnamed: U171.SDO (DO), U172.SDI (DI)
unnamed: U171.CKO (CO), U172.CKI (CI)
unnamed: U172.CKO (CO), U173.CKI (CI)
unnamed: U172.SDO (DO), U173.SDI (DI)
unnamed: U173.CKO (CO), U174.CKI (CI)
unnamed: U173.SDO (DO), U174.SDI (DI)
unnamed: U174.CKO (CO), U175.CKI (CI)
unnamed: U174.SDO (DO), U175.SDI (DI)
unnamed: U176.SDO (DO), U177.SDI (DI)
unnamed: U176.CKO (CO), U177.CKI (CI)
unnamed: U177.CKO (CO), U178.CKI (CI)
unnamed: U177.SDO (DO), U178.SDI (DI)
unnamed: U178.SDO (DO), U179.SDI (DI)
unnamed: U178.CKO (CO), U179.CKI (CI)
unnamed: U179.CKO (CO), U180.CKI (CI)
unnamed: U179.SDO (DO), U180.SDI (DI)
unnamed: U180.CKO (CO), U181.CKI (CI)
unnamed: U180.SDO (DO), U181.SDI (DI)
unnamed: U181.CKO (CO), U182.CKI (CI)
unnamed: U181.SDO (DO), U182.SDI (DI)
unnamed: U175.SDO (DO), U176.SDI (DI)
unnamed: U175.CKO (CO), U176.CKI (CI)
unnamed: U183.SDO (DO), U184.SDI (DI)
unnamed: U183.CKO (CO), U184.CKI (CI)
unnamed: U184.CKO (CO), U185.CKI (CI)
unnamed: U184.SDO (DO), U185.SDI (DI)
unnamed: U185.SDO (DO), U186.SDI (DI)
unnamed: U185.CKO (CO), U186.CKI (CI)
unnamed: U186.CKO (CO), U187.CKI (CI)
unnamed: U186.SDO (DO), U187.SDI (DI)
unnamed: U187.CKO (CO), U188.CKI (CI)
unnamed: U187.SDO (DO), U188.SDI (DI)
unnamed: U188.CKO (CO), U189.CKI (CI)
unnamed: U188.SDO (DO), U189.SDI (DI)
unnamed: U190.SDO (DO), U191.SDI (DI)
unnamed: U190.CKO (CO), U191.CKI (CI)
unnamed: U191.CKO (CO), U192.CKI (CI)
unnamed: U191.SDO (DO), U192.SDI (DI)
unnamed: U192.SDO (DO), U193.SDI (DI)
unnamed: U192.CKO (CO), U193.CKI (CI)
unnamed: U193.CKO (CO), U194.CKI (CI)
unnamed: U193.SDO (DO), U194.SDI (DI)
unnamed: U194.CKO (CO), U195.CKI (CI)
unnamed: U194.SDO (DO), U195.SDI (DI)
unnamed: U189.SDO (DO), U190.SDI (DI)
unnamed: U189.CKO (CO), U190.CKI (CI)
unnamed: U182.SDO (DO), U183.SDI (DI)
unnamed: U182.CKO (CO), U183.CKI (CI)
unnamed: U195.CKO (CO), U196.CKI (CI)
unnamed: U195.SDO (DO), U196.SDI (DI)
SD6: U169.SDI (DI); also elsewhere on the board
SD7: U196.SDO (DO); also elsewhere on the board
VCC: U169.VDD (VCC), U170.VDD (VCC), U171.VDD (VCC), U172.VDD (VCC), U173.VDD (VCC), U174.VDD (VCC), U175.VDD (VCC), U176.VDD (VCC), U177.VDD (VCC), U178.VDD (VCC), U179.VDD (VCC), U180.VDD (VCC), U181.VDD (VCC), U182.VDD (VCC), U183.VDD (VCC), U184.VDD (VCC), U185.VDD (VCC), U186.VDD (VCC), U187.VDD (VCC), U188.VDD (VCC), U189.VDD (VCC), U190.VDD (VCC), U191.VDD (VCC), U192.VDD (VCC), U193.VDD (VCC), U194.VDD (VCC), U195.VDD (VCC), U196.VDD (VCC); also elsewhere on the board
