AndyEngland521/Glasses_Revision/Boards/Glasses/Glasses.brd

## EAGLE design Boards/Glasses/Glasses.brd (continued)

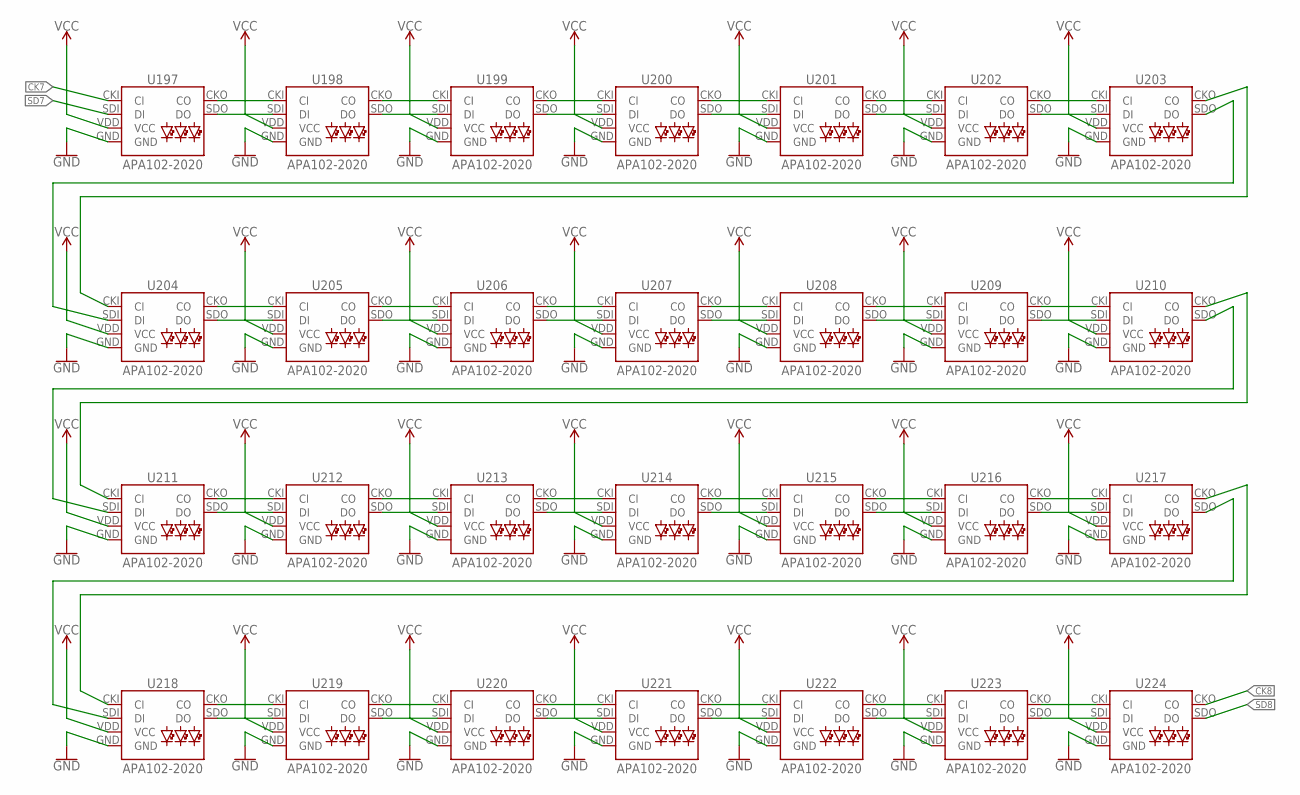
[picture p24: schematic Glasses.sch, sheet 8]

Parts:
U197, U198, U199, U200, U201, U202, U203, U204, U205, U206, U207, U208, U209, U210, U211, U212, U213, U214, U215, U216, U217, U218, U219, U220, U221, U222, U223, U224: APA102-2020

Connections:
CK7: U197.CKI (CI); also elsewhere on the board
CK8: U224.CKO (CO); also elsewhere on the board
GND: U197.GND, U198.GND, U199.GND, U200.GND, U201.GND, U202.GND, U203.GND, U204.GND, U205.GND, U206.GND, U207.GND, U208.GND, U209.GND, U210.GND, U211.GND, U212.GND, U213.GND, U214.GND, U215.GND, U216.GND, U217.GND, U218.GND, U219.GND, U220.GND, U221.GND, U222.GND, U223.GND, U224.GND; also elsewhere on the board
unnamed: U197.SDO (DO), U198.SDI (DI)
unnamed: U197.CKO (CO), U198.CKI (CI)
unnamed: U198.CKO (CO), U199.CKI (CI)
unnamed: U198.SDO (DO), U199.SDI (DI)
unnamed: U199.SDO (DO), U200.SDI (DI)
unnamed: U199.CKO (CO), U200.CKI (CI)
unnamed: U200.CKO (CO), U201.CKI (CI)
unnamed: U200.SDO (DO), U201.SDI (DI)
unnamed: U201.CKO (CO), U202.CKI (CI)
unnamed: U201.SDO (DO), U202.SDI (DI)
unnamed: U202.CKO (CO), U203.CKI (CI)
unnamed: U202.SDO (DO), U203.SDI (DI)
unnamed: U204.SDO (DO), U205.SDI (DI)
unnamed: U204.CKO (CO), U205.CKI (CI)
unnamed: U205.CKO (CO), U206.CKI (CI)
unnamed: U205.SDO (DO), U206.SDI (DI)
unnamed: U206.SDO (DO), U207.SDI (DI)
unnamed: U206.CKO (CO), U207.CKI (CI)
unnamed: U207.CKO (CO), U208.CKI (CI)
unnamed: U207.SDO (DO), U208.SDI (DI)
unnamed: U208.CKO (CO), U209.CKI (CI)
unnamed: U208.SDO (DO), U209.SDI (DI)
unnamed: U209.CKO (CO), U210.CKI (CI)
unnamed: U209.SDO (DO), U210.SDI (DI)
unnamed: U203.SDO (DO), U204.SDI (DI)
unnamed: U203.CKO (CO), U204.CKI (CI)
unnamed: U211.SDO (DO), U212.SDI (DI)
unnamed: U211.CKO (CO), U212.CKI (CI)
unnamed: U212.CKO (CO), U213.CKI (CI)
unnamed: U212.SDO (DO), U213.SDI (DI)
unnamed: U213.SDO (DO), U214.SDI (DI)
unnamed: U213.CKO (CO), U214.CKI (CI)
unnamed: U214.CKO (CO), U215.CKI (CI)
unnamed: U214.SDO (DO), U215.SDI (DI)
unnamed: U215.CKO (CO), U216.CKI (CI)
unnamed: U215.SDO (DO), U216.SDI (DI)
unnamed: U216.CKO (CO), U217.CKI (CI)
unnamed: U216.SDO (DO), U217.SDI (DI)
unnamed: U217.SDO (DO), U218.SDI (DI)
unnamed: U217.CKO (CO), U218.CKI (CI)
unnamed: U210.SDO (DO), U211.SDI (DI)
unnamed: U210.CKO (CO), U211.CKI (CI)
unnamed: U218.CKO (CO), U219.CKI (CI)
unnamed: U218.SDO (DO), U219.SDI (DI)
unnamed: U219.CKO (CO), U220.CKI (CI)
unnamed: U219.SDO (DO), U220.SDI (DI)
unnamed: U220.SDO (DO), U221.SDI (DI)
unnamed: U220.CKO (CO), U221.CKI (CI)
unnamed: U221.CKO (CO), U222.CKI (CI)
unnamed: U221.SDO (DO), U222.SDI (DI)
unnamed: U222.CKO (CO), U223.CKI (CI)
unnamed: U222.SDO (DO), U223.SDI (DI)
unnamed: U223.CKO (CO), U224.CKI (CI)
unnamed: U223.SDO (DO), U224.SDI (DI)
SD7: U197.SDI (DI); also elsewhere on the board
SD8: U224.SDO (DO); also elsewhere on the board
VCC: U197.VDD (VCC), U198.VDD (VCC), U199.VDD (VCC), U200.VDD (VCC), U201.VDD (VCC), U202.VDD (VCC), U203.VDD (VCC), U204.VDD (VCC), U205.VDD (VCC), U206.VDD (VCC), U207.VDD (VCC), U208.VDD (VCC), U209.VDD (VCC), U210.VDD (VCC), U211.VDD (VCC), U212.VDD (VCC), U213.VDD (VCC), U214.VDD (VCC), U215.VDD (VCC), U216.VDD (VCC), U217.VDD (VCC), U218.VDD (VCC), U219.VDD (VCC), U220.VDD (VCC), U221.VDD (VCC), U222.VDD (VCC), U223.VDD (VCC), U224.VDD (VCC); also elsewhere on the board

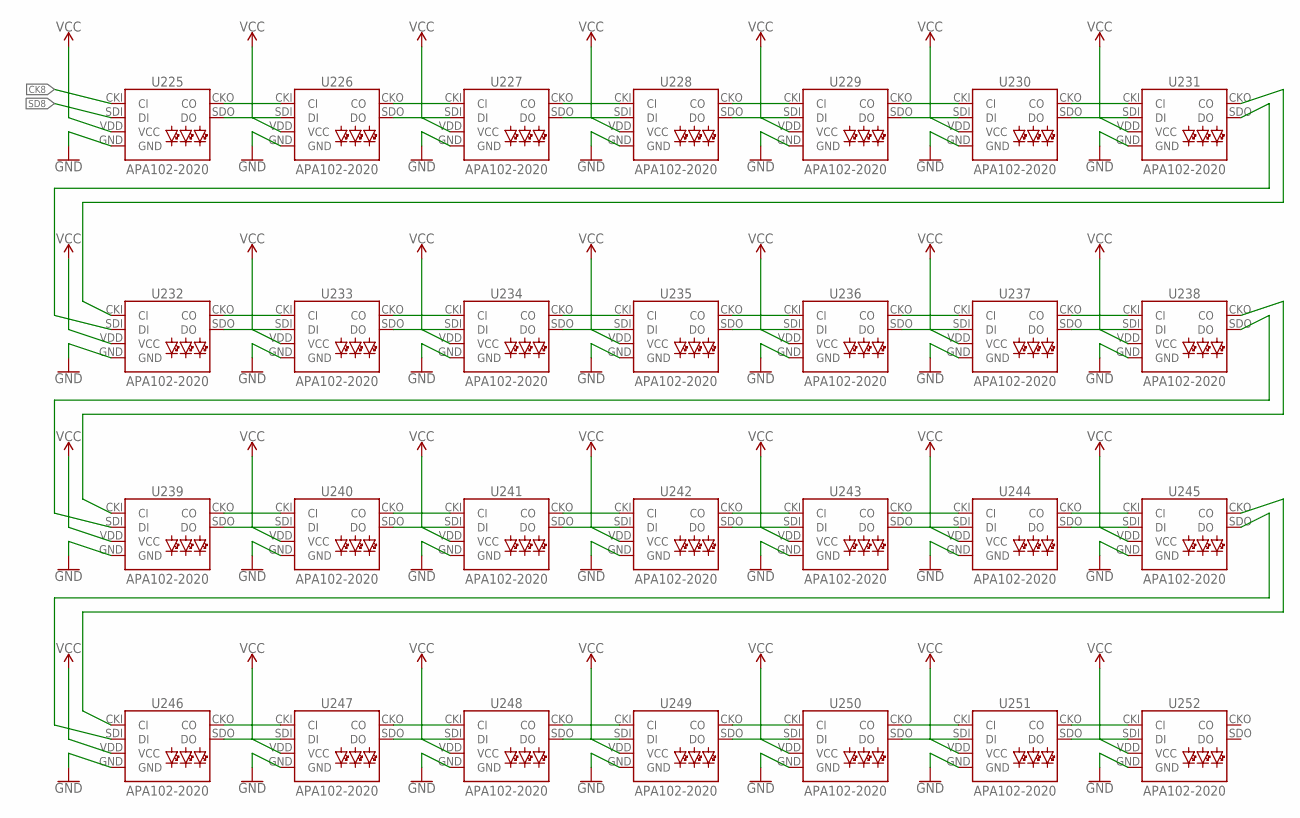
[picture p25: schematic Glasses.sch, sheet 9]

Parts:
U225, U226, U227, U228, U229, U230, U231, U232, U233, U234, U235, U236, U237, U238, U239, U240, U241, U242, U243, U244, U245, U246, U247, U248, U249, U250, U251, U252: APA102-2020

Connections:
CK8: U225.CKI (CI); also elsewhere on the board
GND: U225.GND, U226.GND, U227.GND, U228.GND, U229.GND, U230.GND, U231.GND, U232.GND, U233.GND, U234.GND, U235.GND, U236.GND, U237.GND, U238.GND, U239.GND, U240.GND, U241.GND, U242.GND, U243.GND, U244.GND, U245.GND, U246.GND, U247.GND, U248.GND, U249.GND, U250.GND, U251.GND, U252.GND; also elsewhere on the board
unnamed: U225.SDO (DO), U226.SDI (DI)
unnamed: U225.CKO (CO), U226.CKI (CI)
unnamed: U226.CKO (CO), U227.CKI (CI)
unnamed: U226.SDO (DO), U227.SDI (DI)
unnamed: U227.SDO (DO), U228.SDI (DI)
unnamed: U227.CKO (CO), U228.CKI (CI)
unnamed: U228.CKO (CO), U229.CKI (CI)
unnamed: U228.SDO (DO), U229.SDI (DI)
unnamed: U229.CKO (CO), U230.CKI (CI)
unnamed: U229.SDO (DO), U230.SDI (DI)
unnamed: U230.CKO (CO), U231.CKI (CI)
unnamed: U230.SDO (DO), U231.SDI (DI)
unnamed: U232.SDO (DO), U233.SDI (DI)
unnamed: U232.CKO (CO), U233.CKI (CI)
unnamed: U233.CKO (CO), U234.CKI (CI)
unnamed: U233.SDO (DO), U234.SDI (DI)
unnamed: U234.SDO (DO), U235.SDI (DI)
unnamed: U234.CKO (CO), U235.CKI (CI)
unnamed: U235.CKO (CO), U236.CKI (CI)
unnamed: U235.SDO (DO), U236.SDI (DI)
unnamed: U236.CKO (CO), U237.CKI (CI)
unnamed: U236.SDO (DO), U237.SDI (DI)
unnamed: U237.CKO (CO), U238.CKI (CI)
unnamed: U237.SDO (DO), U238.SDI (DI)
unnamed: U231.SDO (DO), U232.SDI (DI)
unnamed: U231.CKO (CO), U232.CKI (CI)
unnamed: U239.SDO (DO), U240.SDI (DI)
unnamed: U239.CKO (CO), U240.CKI (CI)
unnamed: U240.CKO (CO), U241.CKI (CI)
unnamed: U240.SDO (DO), U241.SDI (DI)
unnamed: U241.SDO (DO), U242.SDI (DI)
unnamed: U241.CKO (CO), U242.CKI (CI)
unnamed: U242.CKO (CO), U243.CKI (CI)
unnamed: U242.SDO (DO), U243.SDI (DI)
unnamed: U243.CKO (CO), U244.CKI (CI)
unnamed: U243.SDO (DO), U244.SDI (DI)
unnamed: U244.CKO (CO), U245.CKI (CI)
unnamed: U244.SDO (DO), U245.SDI (DI)
unnamed: U245.SDO (DO), U246.SDI (DI)
unnamed: U245.CKO (CO), U246.CKI (CI)
unnamed: U238.SDO (DO), U239.SDI (DI)
unnamed: U238.CKO (CO), U239.CKI (CI)
unnamed: U246.CKO (CO), U247.CKI (CI)
unnamed: U246.SDO (DO), U247.SDI (DI)
unnamed: U247.CKO (CO), U248.CKI (CI)
unnamed: U247.SDO (DO), U248.SDI (DI)
unnamed: U248.SDO (DO), U249.SDI (DI)
unnamed: U248.CKO (CO), U249.CKI (CI)
unnamed: U249.CKO (CO), U250.CKI (CI)
unnamed: U249.SDO (DO), U250.SDI (DI)
unnamed: U250.CKO (CO), U251.CKI (CI)
unnamed: U250.SDO (DO), U251.SDI (DI)
unnamed: U251.CKO (CO), U252.CKI (CI)
unnamed: U251.SDO (DO), U252.SDI (DI)
SD8: U225.SDI (DI); also elsewhere on the board
VCC: U225.VDD (VCC), U226.VDD (VCC), U227.VDD (VCC), U228.VDD (VCC), U229.VDD (VCC), U230.VDD (VCC), U231.VDD (VCC), U232.VDD (VCC), U233.VDD (VCC), U234.VDD (VCC), U235.VDD (VCC), U236.VDD (VCC), U237.VDD (VCC), U238.VDD (VCC), U239.VDD (VCC), U240.VDD (VCC), U241.VDD (VCC), U242.VDD (VCC), U243.VDD (VCC), U244.VDD (VCC), U245.VDD (VCC), U246.VDD (VCC), U247.VDD (VCC), U248.VDD (VCC), U249.VDD (VCC), U250.VDD (VCC), U251.VDD (VCC), U252.VDD (VCC); also elsewhere on the board

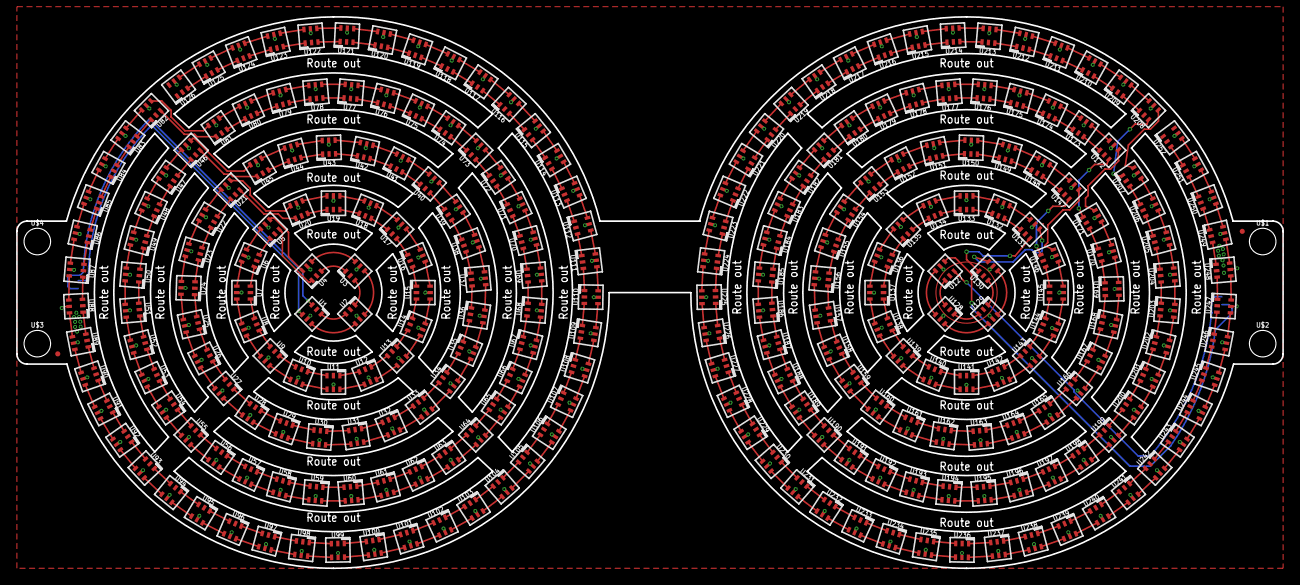
[picture p26: board Glasses.brd from above]

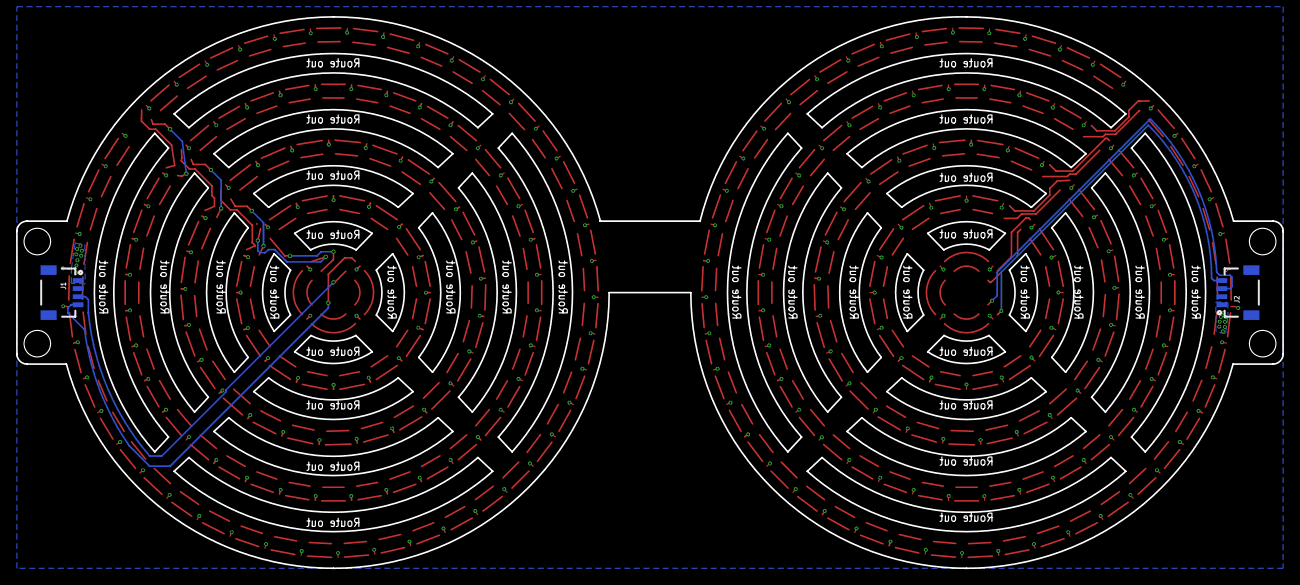
[picture p27: board Glasses.brd from below]

Board: 2 copper layers, 157.5 x 68.6 mm, 260 parts (2 on the bottom side), 506 nets.

Other parts of the board:
U$1, U$2, U$3, U$4: STAND-OFF
