AndyEngland521/Glasses_Revision/Boards/Shield/ESP32Shield.brd

## EAGLE design Boards/Shield/ESP32Shield.brd (2018-10-10)

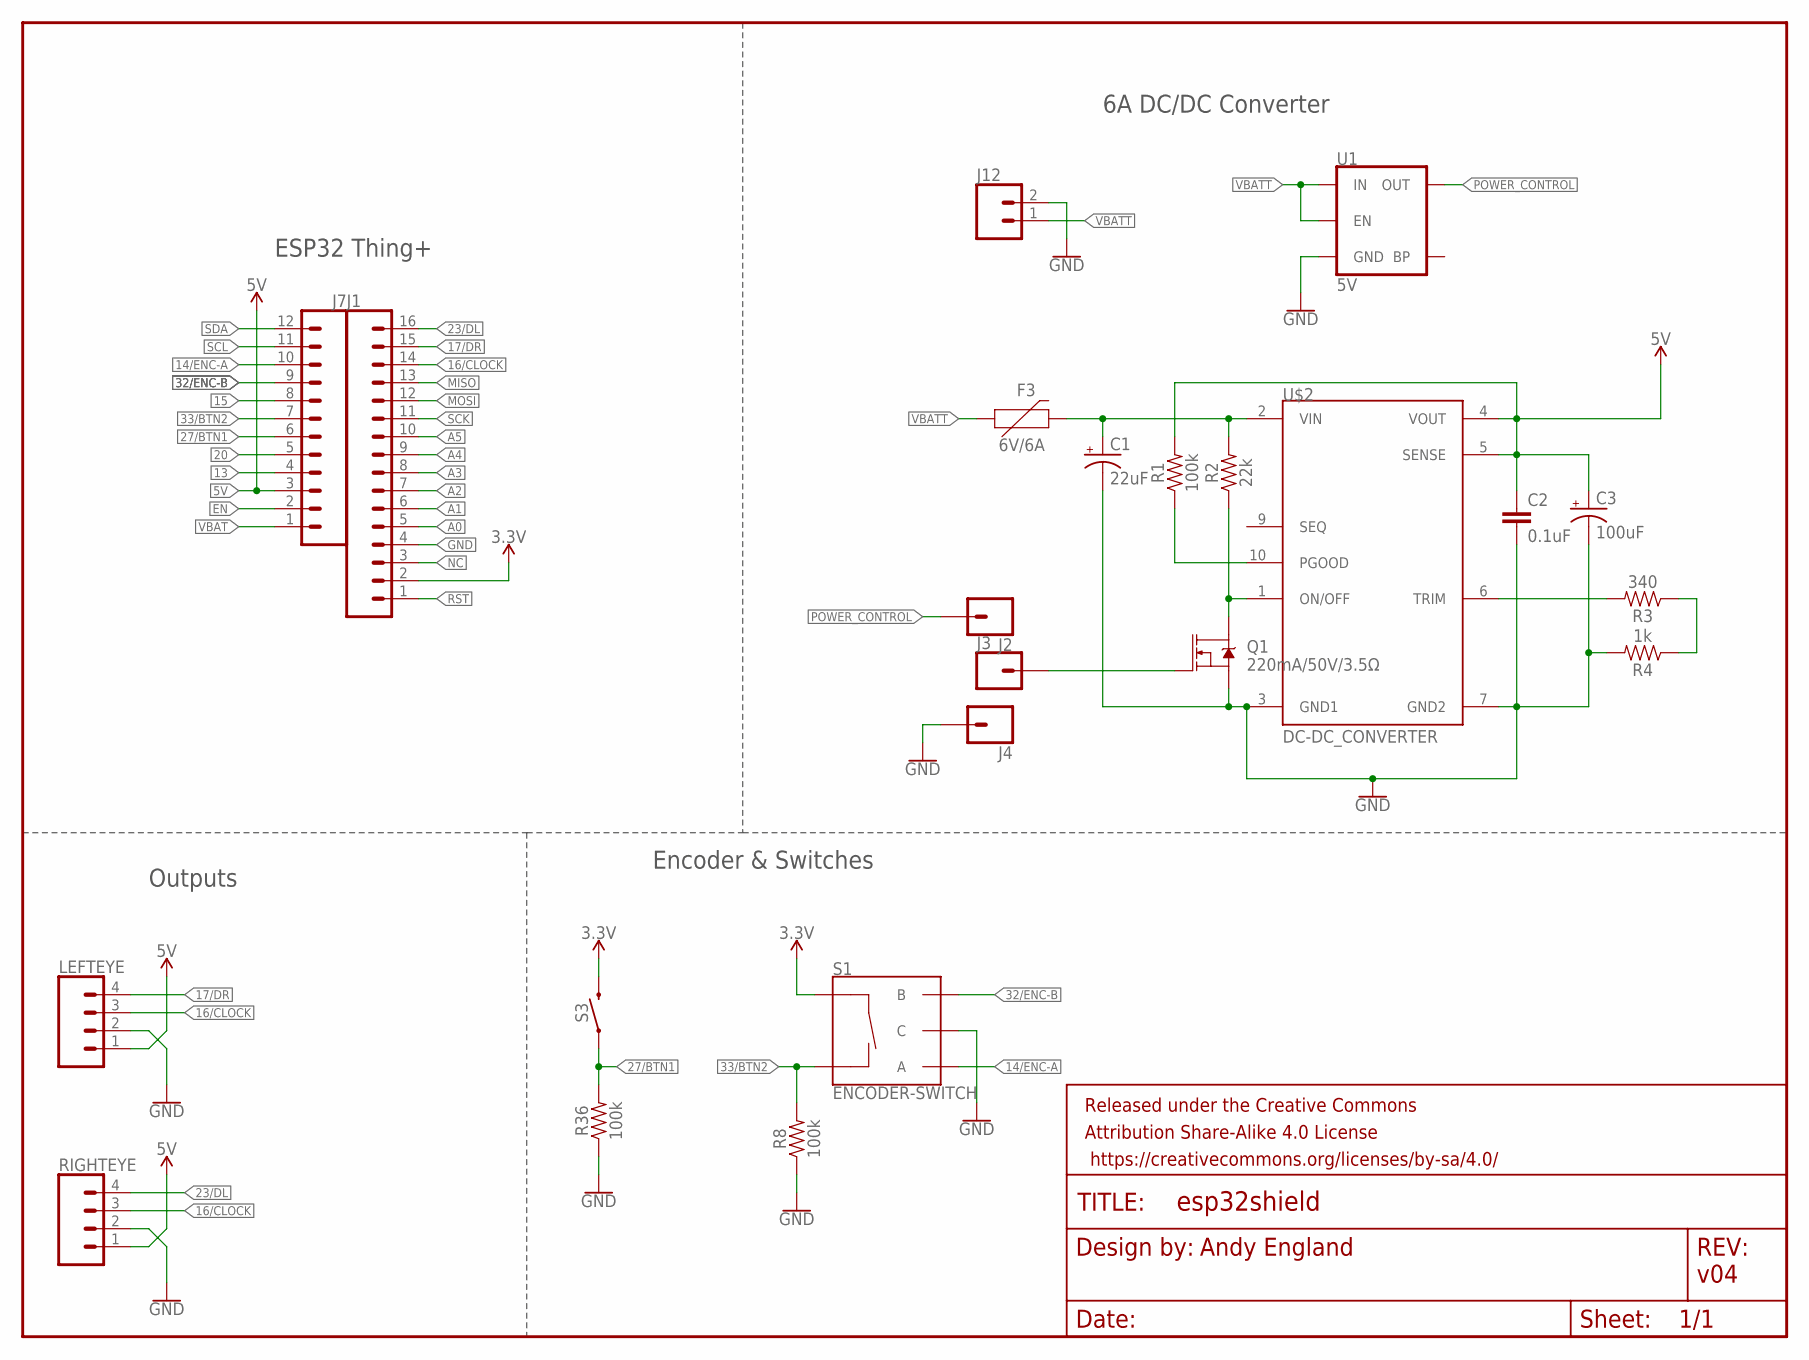
[picture p28: schematic ESP32Shield.sch]

Parts:
C1: 22uF; PANASONIC_C
C2: 0.1uF; 0603
C3: 100uF; PANASONIC_D
F3: 6V/6A; 1206
FRAME1: FRAME-LETTER; CREATIVE_COMMONS
J1: CONN_161X16_NO_SILK; 1X16_NO_SILK
J2, J3, J4: CONN_01; 1X01
J7: CONN_12NO_SILK; 1X12_NO_SILK
J12: CONN_025MM; SCREWTERMINAL-5MM-2
LEFTEYE: CONN_041X04_NO_SILK; 1X04_NO_SILK
Q1: 220mA/50V/3.5Ω; SOT23-3
R1, R8, R36: 100k; 0603
R2: 22k; 0603
R3: 340; 0603
R4: 1k; 0603
RIGHTEYE: CONN_041X04_NO_SILK; 1X04_NO_SILK
S1: ENCODER-SWITCH; ROTARY_ENC_PLAIN
S3: MOMENTARY-SWITCH-SPST-SMD-5.2-REDUNDANT; TACTILE_SWITCH_SMD_5.2MM
U1: 5V; SOT23-5
U$2: DC-DC_CONVERTER

Connections:
3.3V: J1.2, S1.SW+, S3.3 (2), S3.4 (2)
5V: C2.1, C3.+, J7.3, LEFTEYE.1, R1.2, RIGHTEYE.1, U$2.4 (VOUT), U$2.5 (SENSE)
13: J7.4
14/ENC-A: J7.10, S1.A
15: J7.8
16/CLOCK: J1.14, LEFTEYE.3, RIGHTEYE.3
17/DR: J1.15, LEFTEYE.4
20: J7.5
23/DL: J1.16, RIGHTEYE.4
27/BTN1: J7.6, R36.2, S3.1, S3.2 (1)
32/ENC-B: J7.9, S1.B
33/BTN2: J7.7, R8.2, S1.SW-
A0: J1.5
A1: J1.6
A2: J1.7
A3: J1.8
A4: J1.9
A5: J1.10
EN: J7.2
GND: C1.-, C2.2, C3.-, J1.4, J4.1, J12.2, LEFTEYE.2, Q1.2 (S), R4.2, R8.1, R36.1, RIGHTEYE.2, S1.C, U1.2 (GND), U$2.3 (GND1), U$2.7 (GND2)
MISO: J1.13
MOSI: J1.12
unnamed: J3.1, Q1.1 (G)
unnamed: C1.+, F3.2, R2.2, U$2.2 (VIN)
unnamed: Q1.3 (D), R2.1, U$2.1 (ON/OFF)
unnamed: R3.2, U$2.6 (TRIM)
unnamed: R3.1, R4.1
NC: J1.3
PGOOD3: R1.1, U$2.10 (PGOOD)
POWER_CONTROL: J2.1, U1.5 (OUT)
RST: J1.1
SCK: J1.11
SCL: J7.11
SDA: J7.12
VBAT: J7.1
VBATT: F3.1, J12.1, U1.1 (IN), U1.3 (EN)

Notes on the sheet:
ESP32 Thing+
6A DC/DC Converter
Encoder & Switches
Outputs
Andy England
v04

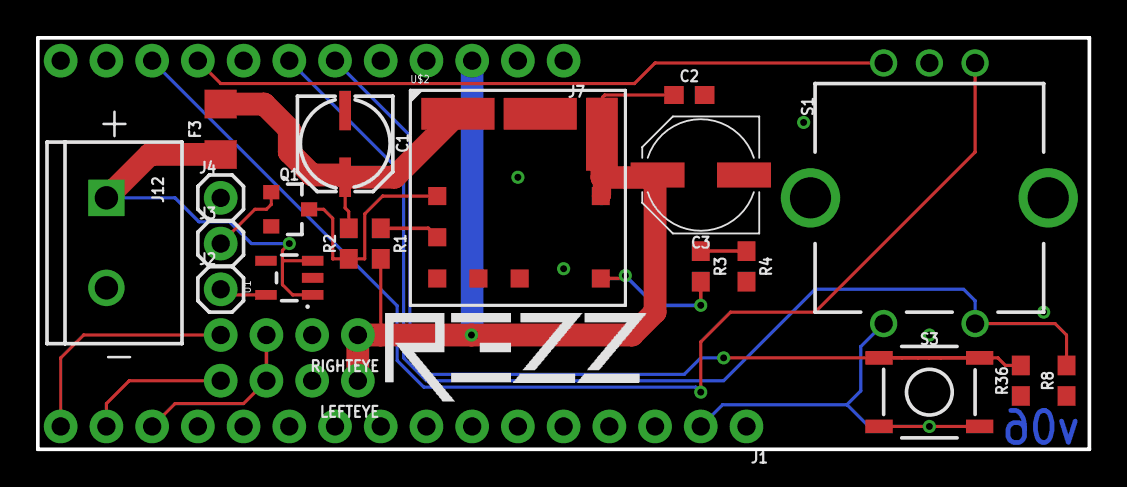
[picture p29: board ESP32Shield.brd from above]

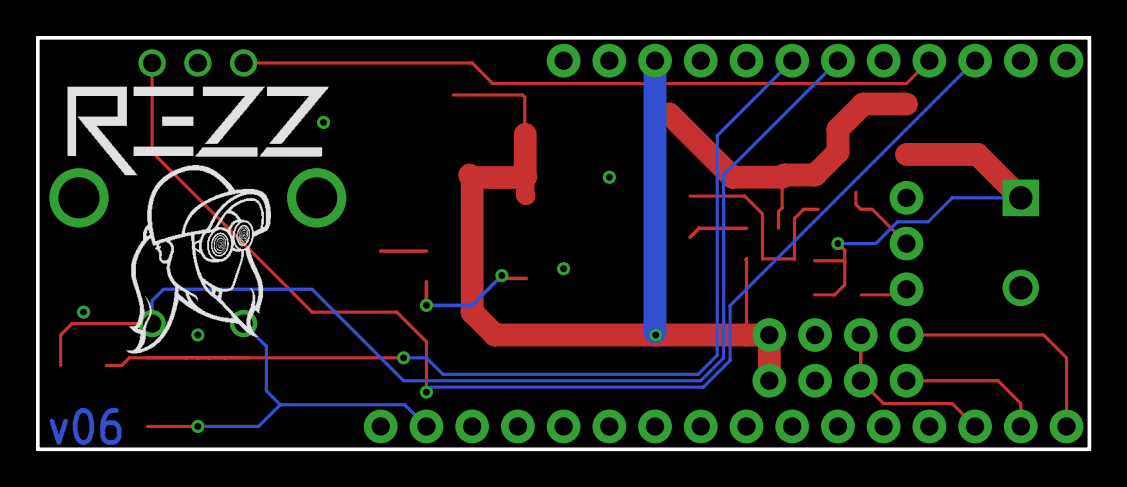
[picture p30: board ESP32Shield.brd from below]

Board: 2 copper layers, 58.4 x 22.9 mm, 27 parts (2 on the bottom side), 18 nets.

Other parts of the board:
U$1, U$4: SWBADNC#JPG
U$3: FB847930393B0F397FC054233C2D7CC6F23D0E39#JPG
