AndyEngland521/Glasses_Revision/(commit log)

2017-11-10 initial commit, board design
    [Glasses.brd]
2017-11-13 began laying out glasses shape
    [Glasses.brd]
2017-11-13 added .brd files
    [Glasses.sch]
2017-11-13 added mockup printout
2017-11-13 Post-print changes
    [Glasses.brd]
2017-11-14 laid out LED's
    [Glasses.brd, Glasses.sch]
2017-12-01 changed diameter, began LED layout
    [Glasses.brd, Glasses.sch]
2017-12-02 laid out footpirnts, routing needed
    [Glasses.brd, Glasses.sch]
2017-12-04 Laid out most of board
    [Glasses.brd, Glasses.sch]
2017-12-05 ordered v01
    [Glasses.GBL, Glasses.GBO, Glasses.GBS, Glasses.GKO, Glasses.GTL, Glasses.GTO, Glasses.GTP, Glasses.GTS]
2017-12-13 Added stems
    [Stem.SLDPRT, Stem.STL]
2017-12-13 glasses brd
    [Glasses.GBL, Glasses.GBO, Glasses.GBS, Glasses.GKO, Glasses.GTL, Glasses.GTO, Glasses.GTP, Glasses.GTS]
2017-12-20 stem v02
    [Stem.SLDPRT, Stem.STL]
2017-12-21 Stem v03
    [Stem.SLDPRT, Stem.STL]
2017-12-22 Stem v04
    [Stem.SLDPRT, Stem.STL]
2018-03-06 started artnet eyeball
    [brain.sch]
2018-03-07 organized directory
    [Glasses.GBL, Glasses.GBO, Glasses.GBS, Glasses.GKO, Glasses.GTL, Glasses.GTO, Glasses.GTP, Glasses.GTS]
2018-03-26 Added stem options
    [Stem_A.SLDPRT, Stem_A.STL, Stem_B.SLDPRT, Stem_B.STL, Stem_C.SLDPRT, Stem_C.STL]
2018-03-30 added stems d and e
    [Stem_D.SLDPRT, Stem_D.STL, Stem_E.SLDPRT, Stem_E.STL]
2018-03-30 added de gcode
2018-04-09 beginning ESP32 Shield schematic
    [Glasses.brd, Glasses.sch, TeensyShield.sch]
2018-04-10 Laid out ESP32 Shield
    [ESP32Shield.brd, ESP32Shield.sch]
2018-04-11 began layout
    [ESP32Shield.brd, ESP32Shield.sch]
2018-04-12 finished ESP32 Shield layout
    [ESP32Shield.brd, ESP32Shield.sch]
2018-04-23 added brainbucket
    [BrainBucket.SLDPRT, BrainBucket.STL]
2018-04-23 updating measures on board
    [ESP32Shield.brd]
2018-04-26 adding new pushbutton
    [ESP32Shield.brd, ESP32Shield.sch]
2018-05-03 Added braincap
    [BrainBucket.SLDPRT, BrainBucket.STL, BrainCap.SLDPRT, BrainCap.STL]
2018-05-14 updated resistors, silk
    [ESP32Shield.GBL, ESP32Shield.GBO, ESP32Shield.GBS, ESP32Shield.GKO, ESP32Shield.GTL, ESP32Shield.GTO, ESP32Shield.GTP, ESP32Shield.GTS]
2018-06-12 Updating interrupts, power structure
    [ESP32Shield.brd, ESP32Shield.sch]
2018-06-13 updating board
    [ESP32Shield.brd]
2018-06-14 adding new ESP8266Thing shield gerber
    [ESP32Shield.brd, ESP32Shield.sch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]
2018-06-15 updating housing
    [BrainBucket.SLDPRT, BrainBucket.STL]
2018-06-20 Adding button and knob
    [Button.SLDPRT, Button.STL, Knob.SLDPRT, Knob.STL]
2018-06-20 Adding gcode for knob and button
2018-06-22 Updating stem and button
    [Button.SLDPRT, Button.STL, Stem.SLDPRT, Stem.STL]
2018-06-22 adding gcode for stem and button
2018-06-22 updating knob and button
    [Button.SLDPRT, Button.STL, Knob.SLDPRT, Knob.STL]
2018-06-23 add knob button
2018-06-23 Updating knob to multipart assembly
    [KnobTop.SLDPRT, KnobTop.STL, knobBottom.SLDPRT, knobBottom.STL]
2018-06-23 updating knob
    [KnobTop.SLDPRT, KnobTop.STL, knobBottom.SLDPRT, knobBottom.STL]
2018-09-14 pushing stl
    [BrainBucket.SLDPRT, BrainBucket.STL]
2018-09-17 updating brainbucket
    [BrainBucket.SLDPRT, BrainBucket.STL]
2018-09-18 fixing interrupt capabilities
2018-09-20 updated brainbucket
    [BrainBucket.SLDPRT, BrainBucket.STL]
2018-09-20 Updating to ESP32 WROOM
    [ESP32Shield.brd, ESP32Shield.sch]
2018-09-28 updating shield
    [ESP32Shield.GBL, ESP32Shield.GBO, ESP32Shield.GBS, ESP32Shield.GKO, ESP32Shield.GTL, ESP32Shield.GTO, ESP32Shield.GTP, ESP32Shield.GTS]
2018-10-10 updating board to V06, finangling code to work with WROOM
    [ESP32Shield.brd, ESP32Shield.sch]
2018-10-11 changing menus to enums, organizing code, fixed screen
    [Glasses.ino]
2018-12-05 adding stem .stl
    have battery powered device. adding stems to glasses.
    [Stem.SLDPRT, Stem.STL]
2018-12-05 adding final case
    adding final case, both with and without belt loop
    [BrainBucket.SLDPRT, BrainBucket.STL, BrainBucketnoLoop.SLDPRT, BrainBucketnoLoop.STL]
2018-12-05 Updating to new button
    [Button.SLDPRT, Button.STL]
2018-12-05 Adding slot for qwiic
    [BrainBucket.SLDPRT, BrainBucket.STL, BrainBucketnoLoop.SLDPRT, BrainBucketnoLoop.STL]
2018-12-06 adding gcode
    [Glasses.brd, Glasses.sch]
2019-09-18 gcode for button
